jerrekt/Bricked-Sorting/cad/README.md

# CAD

- `v14/INTERFACE.md` and `v14/interface.json`: the shared spec for the V14 parallel CAD chats (frame, drawer, scoop, deck).
- `reference_v13/`: V13 parts and scripts to reuse or copy from (STEP, CadQuery 2.8 scripts, the V13 assembly placements in `assembly.json`). Reference only; V14 parts go in `v14/<module>/`.
