jerrekt/Bricked-Sorting/cad/v14/frame/cut_list.md

# V14 frame: wood cut list (interface 5)

All straight crosscuts. Nominal 2x2 = 38 x 38 actual, 1x2 = 19 x 38 actual (check the actual lumber; the skin clips assume 6 mm from wood face to skin). The store cuts the plywood.

| # | Piece | Stock | Cut (mm) | Cut (in) | Qty | Position |
|---|---|---|---|---|---|---|
| 100 | corner post | 2x2 | 600 | 23.62 | 4 | |x| 316..354, |y| 136..174, z 12..612 |
| 101 | top rail, long | 1x2 (38 tall) | 632 | 24.88 | 2 | y +-155..174, z 574..612, between the posts |
| 102 | top rail, short | 1x2 (38 tall) | 272 | 10.71 | 2 | x +-335..354, z 574..612, between the posts |
| 103 | deck cleat, long | 1x2 (38 tall) | 632 | 24.88 | 2 | y +-155..174, z 262..300 |
| 104 | deck cleat, short | 1x2 (38 tall) | 272 | 10.71 | 2 | x +-335..354, z 262..300 |
| 105 | bottom rail, short walls | 1x2 (38 tall) | 272 | 10.71 | 2 | x +-335..354, z 12..50 |
| 106 | beam post | 1x2 | 212 | 8.35 | 2 | x +-335..354, y -19..19, z 50..262 (vertical, 19 face toward the wall) |
| 109 | roof cross rail (under the hopper stud) | 1x2 laid FLAT | 310 | 12.20 | 2 | x -292 and -68 (centres), y -155..155 between the long top rails, z 593..612; 38 face up |
| 107 | floor plywood | 1/2 in ply | 720 x 360 | 28.35 x 14.17 | 1 | z 0..12 |
| 108 | deck plywood | 1/2 in ply | 708 x 348 | 27.87 x 13.70 | 1 | z 300..312; 38 x 38 notch at each corner; 56 mm (2 3/16 in) hole at (240, 0) for the drop funnel |

Stock: 2x2 x 8 ft x 1 (4 x 600 = 2400 of 2438, cut carefully), 1x2 x 8 ft x 3 (632 + 632 + 272 + 272 + 272 = 2080; 632 + 632 + 272 + 272 + 212 + 212 = 2232; 310 + 310 = 620), 1/2 in plywood 2 x 4 ft handy panel x 1.

## Wood-to-wood screws (pilot 2.5 mm for #6, 3 mm for #8)

| Joint | Screw | Qty | Where |
|---|---|---|---|
| posts to floor ply | #6 x 1-1/4 in, up from below the ply (12 ply + 20 into the post) | 16 | 4 per post, at the post centre (x +-335, y +-155) +-10 in x and y |
| long rails 101 / cleats 103 to posts | #8 x 2.5 in, through the post outer x face (+-354) into the rail end grain | 8 | 2 per rail end: y +-164.5, z 584 and 602 (rail) / 272 and 290 (cleat) |
| short rails 102 / cleats 104 / bottom rails 105 to posts | #8 x 2.5 in, through the post outer y face (+-174) into the end grain | 24 | 2 per end: x +-344.5, z 584/602, 272/290, 22/40 |
| beam post 106 to bottom rail 105 | #8 x 2.5 in, up from below the floor ply through rail 105 | 2 | at (+-344.5, 0) |
| beam post 106 to deck cleat 104 | #8 x 2.5 in, down through the cleat top | 2 | at (+-344.5, 0), before the deck ply goes on |
| deck ply 108 to cleats | #6 x 1.25 in, from above | 12 | 3 per cleat, on the cleat centreline (y +-164.5 / x +-344.5) |
| cross rails 109 to long top rails | #8 x 2.5 in toe-screwed (pocket style) down from the cross rail top face into the long rail, 2 per end, before the roof goes on | 8 | at x -292 / -68, y +-140, ~15 deg off vertical toward the long rail |

Order: posts onto the floor ply; bottom rails 105; beam posts 106; cleats 103/104; top rails 101/102; drill the clip pilots (drilling_map.md); clips; deck ply last (after the drawer rails, which screw into the floor).
