jerrekt/Bricked-Sorting/cad/v14/frame/drilling_map.md

# V14 frame: drilling map for the printed clips and keeper bars (interface 5)

Every hole: 2.5 mm pilot for a #6 x 3/4 in wood screw, drilled perpendicular to the face named, at the machine coordinates given (mm; origin floor centre, +Y front, +X the front viewer's left). Post outer faces are at y = +-174 (front/back) and x = +-354 (sides); the rail and cleat outer faces share those planes. The C3 roof clips go on the INNER faces of the top rails (y = +-155, x = +-335) at z 586: drill and fit them before the roof goes on.

| # | Part | Face | x | y | z | Holds |
|---|---|---|---|---|---|---|
| 1 | clip C1 | y +174 (post / cleat / rail outer face) | -328.7 | 174.0 | 62.0 | post, tile edge rib |
| 2 | clip C1 | y +174 (post / cleat / rail outer face) | -328.7 | 174.0 | 162.0 | post, tile edge rib |
| 3 | clip C1 | y +174 (post / cleat / rail outer face) | -301.0 | 174.0 | 274.5 | cleat, tile rib |
| 4 | clip C1 | y +174 (post / cleat / rail outer face) | -215.0 | 174.0 | 274.5 | cleat, tile rib |
| 5 | clip C1 | y +174 (post / cleat / rail outer face) | -328.7 | 174.0 | 262.0 | post, tile edge rib |
| 6 | clip C1 | y +174 (post / cleat / rail outer face) | -328.7 | 174.0 | 362.0 | post, tile edge rib |
| 7 | clip C1 | y +174 (post / cleat / rail outer face) | -301.0 | 174.0 | 586.5 | top rail, tile rib |
| 8 | clip C1 | y +174 (post / cleat / rail outer face) | -215.0 | 174.0 | 586.5 | top rail, tile rib |
| 9 | clip C1 | y +174 (post / cleat / rail outer face) | -328.7 | 174.0 | 462.0 | post, tile edge rib |
| 10 | clip C1 | y +174 (post / cleat / rail outer face) | -328.7 | 174.0 | 562.0 | post, tile edge rib |
| 11 | clip C1 | y +174 (post / cleat / rail outer face) | -145.0 | 174.0 | 274.5 | cleat, tile rib |
| 12 | clip C1 | y +174 (post / cleat / rail outer face) | -35.0 | 174.0 | 274.5 | cleat, tile rib |
| 13 | clip C1 | y +174 (post / cleat / rail outer face) | -145.0 | 174.0 | 586.5 | top rail, tile rib |
| 14 | clip C1 | y +174 (post / cleat / rail outer face) | -35.0 | 174.0 | 586.5 | top rail, tile rib |
| 15 | clip C1 | y +174 (post / cleat / rail outer face) | 35.0 | 174.0 | 274.5 | cleat, tile rib |
| 16 | clip C1 | y +174 (post / cleat / rail outer face) | 145.0 | 174.0 | 274.5 | cleat, tile rib |
| 17 | clip C1 | y +174 (post / cleat / rail outer face) | 35.0 | 174.0 | 586.5 | top rail, tile rib |
| 18 | clip C1 | y +174 (post / cleat / rail outer face) | 145.0 | 174.0 | 586.5 | top rail, tile rib |
| 19 | clip C1 | y +174 (post / cleat / rail outer face) | 328.7 | 174.0 | 62.0 | post, tile edge rib |
| 20 | clip C1 | y +174 (post / cleat / rail outer face) | 328.7 | 174.0 | 162.0 | post, tile edge rib |
| 21 | clip C1 | y +174 (post / cleat / rail outer face) | 215.0 | 174.0 | 274.5 | cleat, tile rib |
| 22 | clip C1 | y +174 (post / cleat / rail outer face) | 301.0 | 174.0 | 274.5 | cleat, tile rib |
| 23 | clip C1 | y +174 (post / cleat / rail outer face) | 328.7 | 174.0 | 262.0 | post, tile edge rib |
| 24 | clip C1 | y +174 (post / cleat / rail outer face) | 328.7 | 174.0 | 362.0 | post, tile edge rib |
| 25 | clip C1 | y +174 (post / cleat / rail outer face) | 215.0 | 174.0 | 586.5 | top rail, tile rib |
| 26 | clip C1 | y +174 (post / cleat / rail outer face) | 301.0 | 174.0 | 586.5 | top rail, tile rib |
| 27 | clip C1 | y +174 (post / cleat / rail outer face) | 328.7 | 174.0 | 462.0 | post, tile edge rib |
| 28 | clip C1 | y +174 (post / cleat / rail outer face) | 328.7 | 174.0 | 562.0 | post, tile edge rib |
| 29 | clip C1 | y -174 (post / cleat / rail outer face) | -328.7 | -174.0 | 62.0 | post, tile edge rib |
| 30 | clip C1 | y -174 (post / cleat / rail outer face) | -328.7 | -174.0 | 162.0 | post, tile edge rib |
| 31 | clip C1 | y -174 (post / cleat / rail outer face) | -301.0 | -174.0 | 274.5 | cleat, tile rib |
| 32 | clip C1 | y -174 (post / cleat / rail outer face) | -235.0 | -174.0 | 274.5 | cleat, tile rib |
| 33 | clip C1 | y -174 (post / cleat / rail outer face) | -328.7 | -174.0 | 262.0 | post, tile edge rib |
| 34 | clip C1 | y -174 (post / cleat / rail outer face) | -328.7 | -174.0 | 362.0 | post, tile edge rib |
| 35 | clip C1 | y -174 (post / cleat / rail outer face) | -301.0 | -174.0 | 586.5 | top rail, tile rib |
| 36 | clip C1 | y -174 (post / cleat / rail outer face) | -235.0 | -174.0 | 586.5 | top rail, tile rib |
| 37 | clip C1 | y -174 (post / cleat / rail outer face) | -328.7 | -174.0 | 462.0 | post, tile edge rib |
| 38 | clip C1 | y -174 (post / cleat / rail outer face) | -328.7 | -174.0 | 562.0 | post, tile edge rib |
| 39 | clip C1 | y -174 (post / cleat / rail outer face) | -130.0 | -174.0 | 274.5 | cleat, tile rib |
| 40 | clip C1 | y -174 (post / cleat / rail outer face) | -70.0 | -174.0 | 274.5 | cleat, tile rib |
| 41 | clip C1 | y -174 (post / cleat / rail outer face) | -130.0 | -174.0 | 586.5 | top rail, tile rib |
| 42 | clip C1 | y -174 (post / cleat / rail outer face) | -70.0 | -174.0 | 586.5 | top rail, tile rib |
| 43 | clip C1 | y -174 (post / cleat / rail outer face) | 70.0 | -174.0 | 274.5 | cleat, tile rib |
| 44 | clip C1 | y -174 (post / cleat / rail outer face) | 130.0 | -174.0 | 274.5 | cleat, tile rib |
| 45 | clip C1 | y -174 (post / cleat / rail outer face) | 70.0 | -174.0 | 586.5 | top rail, tile rib |
| 46 | clip C1 | y -174 (post / cleat / rail outer face) | 130.0 | -174.0 | 586.5 | top rail, tile rib |
| 47 | clip C1 | y -174 (post / cleat / rail outer face) | 328.7 | -174.0 | 62.0 | post, tile edge rib |
| 48 | clip C1 | y -174 (post / cleat / rail outer face) | 328.7 | -174.0 | 162.0 | post, tile edge rib |
| 49 | clip C1 | y -174 (post / cleat / rail outer face) | 235.0 | -174.0 | 274.5 | cleat, tile rib |
| 50 | clip C1 | y -174 (post / cleat / rail outer face) | 301.0 | -174.0 | 274.5 | cleat, tile rib |
| 51 | clip C1 | y -174 (post / cleat / rail outer face) | 328.7 | -174.0 | 262.0 | post, tile edge rib |
| 52 | clip C1 | y -174 (post / cleat / rail outer face) | 328.7 | -174.0 | 362.0 | post, tile edge rib |
| 53 | clip C1 | y -174 (post / cleat / rail outer face) | 235.0 | -174.0 | 586.5 | top rail, tile rib |
| 54 | clip C1 | y -174 (post / cleat / rail outer face) | 301.0 | -174.0 | 586.5 | top rail, tile rib |
| 55 | clip C1 | y -174 (post / cleat / rail outer face) | 328.7 | -174.0 | 462.0 | post, tile edge rib |
| 56 | clip C1 | y -174 (post / cleat / rail outer face) | 328.7 | -174.0 | 562.0 | post, tile edge rib |
| 57 | clip C1 | x +354 (post / rail outer face) | 354.0 | -121.0 | 24.5 | bottom rail, tile rib |
| 58 | clip C1 | x +354 (post / rail outer face) | 354.0 | -35.0 | 24.5 | bottom rail, tile rib |
| 59 | clip C1 | x +354 (post / rail outer face) | 354.0 | -148.7 | 62.0 | post, tile edge rib |
| 60 | clip C1 | x +354 (post / rail outer face) | 354.0 | -148.7 | 162.0 | post, tile edge rib |
| 61 | clip C2 | x +354 (post / rail outer face) | 354.0 | 7.3 | 110.0 | beam post, seam ribs |
| 62 | clip C2 | x +354 (post / rail outer face) | 354.0 | 7.3 | 185.0 | beam post, seam ribs |
| 63 | clip C1 | x +354 (post / rail outer face) | 354.0 | -121.0 | 274.5 | cleat, tile rib |
| 64 | clip C1 | x +354 (post / rail outer face) | 354.0 | -35.0 | 274.5 | cleat, tile rib |
| 65 | clip C1 | x +354 (post / rail outer face) | 354.0 | -148.7 | 262.0 | post, tile edge rib |
| 66 | clip C1 | x +354 (post / rail outer face) | 354.0 | -148.7 | 362.0 | post, tile edge rib |
| 67 | clip C2 | x +354 (post / rail outer face) | 354.0 | 7.3 | 240.0 | beam post, seam ribs |
| 68 | clip C1 | x +354 (post / rail outer face) | 354.0 | -121.0 | 586.5 | top rail, tile rib |
| 69 | clip C1 | x +354 (post / rail outer face) | 354.0 | -35.0 | 586.5 | top rail, tile rib |
| 70 | clip C1 | x +354 (post / rail outer face) | 354.0 | -148.7 | 462.0 | post, tile edge rib |
| 71 | clip C1 | x +354 (post / rail outer face) | 354.0 | -148.7 | 562.0 | post, tile edge rib |
| 72 | clip C1 | x +354 (post / rail outer face) | 354.0 | 35.0 | 24.5 | bottom rail, tile rib |
| 73 | clip C1 | x +354 (post / rail outer face) | 354.0 | 121.0 | 24.5 | bottom rail, tile rib |
| 74 | clip C1 | x +354 (post / rail outer face) | 354.0 | 148.7 | 62.0 | post, tile edge rib |
| 75 | clip C1 | x +354 (post / rail outer face) | 354.0 | 148.7 | 162.0 | post, tile edge rib |
| 76 | clip C1 | x +354 (post / rail outer face) | 354.0 | 35.0 | 274.5 | cleat, tile rib |
| 77 | clip C1 | x +354 (post / rail outer face) | 354.0 | 121.0 | 274.5 | cleat, tile rib |
| 78 | clip C1 | x +354 (post / rail outer face) | 354.0 | 148.7 | 262.0 | post, tile edge rib |
| 79 | clip C1 | x +354 (post / rail outer face) | 354.0 | 148.7 | 362.0 | post, tile edge rib |
| 80 | clip C1 | x +354 (post / rail outer face) | 354.0 | 35.0 | 586.5 | top rail, tile rib |
| 81 | clip C1 | x +354 (post / rail outer face) | 354.0 | 121.0 | 586.5 | top rail, tile rib |
| 82 | clip C1 | x +354 (post / rail outer face) | 354.0 | 148.7 | 462.0 | post, tile edge rib |
| 83 | clip C1 | x +354 (post / rail outer face) | 354.0 | 148.7 | 562.0 | post, tile edge rib |
| 84 | clip C1 | x -354 (post / rail outer face) | -354.0 | -121.0 | 24.5 | bottom rail, tile rib |
| 85 | clip C1 | x -354 (post / rail outer face) | -354.0 | -35.0 | 24.5 | bottom rail, tile rib |
| 86 | clip C1 | x -354 (post / rail outer face) | -354.0 | -148.7 | 62.0 | post, tile edge rib |
| 87 | clip C1 | x -354 (post / rail outer face) | -354.0 | -148.7 | 162.0 | post, tile edge rib |
| 88 | clip C2 | x -354 (post / rail outer face) | -354.0 | -7.3 | 110.0 | beam post, seam ribs |
| 89 | clip C2 | x -354 (post / rail outer face) | -354.0 | -7.3 | 185.0 | beam post, seam ribs |
| 90 | clip C1 | x -354 (post / rail outer face) | -354.0 | -121.0 | 274.5 | cleat, tile rib |
| 91 | clip C1 | x -354 (post / rail outer face) | -354.0 | -35.0 | 274.5 | cleat, tile rib |
| 92 | clip C1 | x -354 (post / rail outer face) | -354.0 | -148.7 | 262.0 | post, tile edge rib |
| 93 | clip C1 | x -354 (post / rail outer face) | -354.0 | -148.7 | 362.0 | post, tile edge rib |
| 94 | clip C2 | x -354 (post / rail outer face) | -354.0 | -7.3 | 240.0 | beam post, seam ribs |
| 95 | clip C1 | x -354 (post / rail outer face) | -354.0 | -121.0 | 586.5 | top rail, tile rib |
| 96 | clip C1 | x -354 (post / rail outer face) | -354.0 | -35.0 | 586.5 | top rail, tile rib |
| 97 | clip C1 | x -354 (post / rail outer face) | -354.0 | -148.7 | 462.0 | post, tile edge rib |
| 98 | clip C1 | x -354 (post / rail outer face) | -354.0 | -148.7 | 562.0 | post, tile edge rib |
| 99 | clip C1 | x -354 (post / rail outer face) | -354.0 | 35.0 | 24.5 | bottom rail, tile rib |
| 100 | clip C1 | x -354 (post / rail outer face) | -354.0 | 121.0 | 24.5 | bottom rail, tile rib |
| 101 | clip C1 | x -354 (post / rail outer face) | -354.0 | 148.7 | 62.0 | post, tile edge rib |
| 102 | clip C1 | x -354 (post / rail outer face) | -354.0 | 148.7 | 162.0 | post, tile edge rib |
| 103 | clip C1 | x -354 (post / rail outer face) | -354.0 | 35.0 | 274.5 | cleat, tile rib |
| 104 | clip C1 | x -354 (post / rail outer face) | -354.0 | 121.0 | 274.5 | cleat, tile rib |
| 105 | clip C1 | x -354 (post / rail outer face) | -354.0 | 148.7 | 262.0 | post, tile edge rib |
| 106 | clip C1 | x -354 (post / rail outer face) | -354.0 | 148.7 | 362.0 | post, tile edge rib |
| 107 | clip C1 | x -354 (post / rail outer face) | -354.0 | 35.0 | 586.5 | top rail, tile rib |
| 108 | clip C1 | x -354 (post / rail outer face) | -354.0 | 121.0 | 586.5 | top rail, tile rib |
| 109 | clip C1 | x -354 (post / rail outer face) | -354.0 | 148.7 | 462.0 | post, tile edge rib |
| 110 | clip C1 | x -354 (post / rail outer face) | -354.0 | 148.7 | 562.0 | post, tile edge rib |
| 111 | clip C1 | y -174 (post / cleat / rail outer face) | -339.5 | -174.0 | 112.0 | post, corner cap rib |
| 112 | clip C1 | x -354 (post / rail outer face) | -354.0 | -160.5 | 112.0 | post, corner cap rib |
| 113 | clip C1 | y -174 (post / cleat / rail outer face) | -339.5 | -174.0 | 312.0 | post, corner cap rib |
| 114 | clip C1 | x -354 (post / rail outer face) | -354.0 | -160.5 | 312.0 | post, corner cap rib |
| 115 | clip C1 | y -174 (post / cleat / rail outer face) | -339.5 | -174.0 | 512.0 | post, corner cap rib |
| 116 | clip C1 | x -354 (post / rail outer face) | -354.0 | -160.5 | 512.0 | post, corner cap rib |
| 117 | clip C1 | y +174 (post / cleat / rail outer face) | -339.5 | 174.0 | 112.0 | post, corner cap rib |
| 118 | clip C1 | x -354 (post / rail outer face) | -354.0 | 160.5 | 112.0 | post, corner cap rib |
| 119 | clip C1 | y +174 (post / cleat / rail outer face) | -339.5 | 174.0 | 312.0 | post, corner cap rib |
| 120 | clip C1 | x -354 (post / rail outer face) | -354.0 | 160.5 | 312.0 | post, corner cap rib |
| 121 | clip C1 | y +174 (post / cleat / rail outer face) | -339.5 | 174.0 | 512.0 | post, corner cap rib |
| 122 | clip C1 | x -354 (post / rail outer face) | -354.0 | 160.5 | 512.0 | post, corner cap rib |
| 123 | clip C1 | y -174 (post / cleat / rail outer face) | 339.5 | -174.0 | 112.0 | post, corner cap rib |
| 124 | clip C1 | x +354 (post / rail outer face) | 354.0 | -160.5 | 112.0 | post, corner cap rib |
| 125 | clip C1 | y -174 (post / cleat / rail outer face) | 339.5 | -174.0 | 312.0 | post, corner cap rib |
| 126 | clip C1 | x +354 (post / rail outer face) | 354.0 | -160.5 | 312.0 | post, corner cap rib |
| 127 | clip C1 | y -174 (post / cleat / rail outer face) | 339.5 | -174.0 | 512.0 | post, corner cap rib |
| 128 | clip C1 | x +354 (post / rail outer face) | 354.0 | -160.5 | 512.0 | post, corner cap rib |
| 129 | clip C1 | y +174 (post / cleat / rail outer face) | 339.5 | 174.0 | 112.0 | post, corner cap rib |
| 130 | clip C1 | x +354 (post / rail outer face) | 354.0 | 160.5 | 112.0 | post, corner cap rib |
| 131 | clip C1 | y +174 (post / cleat / rail outer face) | 339.5 | 174.0 | 312.0 | post, corner cap rib |
| 132 | clip C1 | x +354 (post / rail outer face) | 354.0 | 160.5 | 312.0 | post, corner cap rib |
| 133 | clip C1 | y +174 (post / cleat / rail outer face) | 339.5 | 174.0 | 512.0 | post, corner cap rib |
| 134 | clip C1 | x +354 (post / rail outer face) | 354.0 | 160.5 | 512.0 | post, corner cap rib |
| 135 | clip C3 | long top rail inner face y -155 | -244.0 | -155.0 | 586.2 | top rail inner face, roof rib |
| 136 | clip C3 | long top rail inner face y -155 | -210.0 | -155.0 | 586.2 | top rail inner face, roof rib |
| 137 | clip C3 | short top rail inner face x -335 | -335.0 | -120.0 | 586.2 | short top rail inner face, roof rib |
| 138 | clip C3 | short top rail inner face x -335 | -335.0 | -60.0 | 586.2 | short top rail inner face, roof rib |
| 139 | clip C3 | long top rail inner face y +155 | -244.0 | 155.0 | 586.2 | top rail inner face, roof rib |
| 140 | clip C3 | long top rail inner face y +155 | -210.0 | 155.0 | 586.2 | top rail inner face, roof rib |
| 141 | clip C3 | short top rail inner face x -335 | -335.0 | 60.0 | 586.2 | short top rail inner face, roof rib |
| 142 | clip C3 | short top rail inner face x -335 | -335.0 | 120.0 | 586.2 | short top rail inner face, roof rib |
| 143 | clip C3 | long top rail inner face y -155 | -150.0 | -155.0 | 586.2 | top rail inner face, roof rib |
| 144 | clip C3 | long top rail inner face y -155 | -30.0 | -155.0 | 586.2 | top rail inner face, roof rib |
| 145 | clip C3 | long top rail inner face y +155 | -150.0 | 155.0 | 586.2 | top rail inner face, roof rib |
| 146 | clip C3 | long top rail inner face y +155 | -30.0 | 155.0 | 586.2 | top rail inner face, roof rib |
| 147 | clip C3 | long top rail inner face y -155 | 30.0 | -155.0 | 586.2 | top rail inner face, roof rib |
| 148 | clip C3 | long top rail inner face y -155 | 150.0 | -155.0 | 586.2 | top rail inner face, roof rib |
| 149 | clip C3 | long top rail inner face y +155 | 30.0 | 155.0 | 586.2 | top rail inner face, roof rib |
| 150 | clip C3 | long top rail inner face y +155 | 150.0 | 155.0 | 586.2 | top rail inner face, roof rib |
| 151 | clip C3 | long top rail inner face y -155 | 210.0 | -155.0 | 586.2 | top rail inner face, roof rib |
| 152 | clip C3 | long top rail inner face y -155 | 280.0 | -155.0 | 586.2 | top rail inner face, roof rib |
| 153 | clip C3 | short top rail inner face x +335 | 335.0 | -120.0 | 586.2 | short top rail inner face, roof rib |
| 154 | clip C3 | short top rail inner face x +335 | 335.0 | -60.0 | 586.2 | short top rail inner face, roof rib |
| 155 | clip C3 | long top rail inner face y +155 | 210.0 | 155.0 | 586.2 | top rail inner face, roof rib |
| 156 | clip C3 | long top rail inner face y +155 | 280.0 | 155.0 | 586.2 | top rail inner face, roof rib |
| 157 | clip C3 | short top rail inner face x +335 | 335.0 | 60.0 | 586.2 | short top rail inner face, roof rib |
| 158 | clip C3 | short top rail inner face x +335 | 335.0 | 120.0 | 586.2 | short top rail inner face, roof rib |
| 159 | keeper bar 116 | y -174 (deck cleat outer face) | -150.0 | -174.0 | 281.0 | access panel keeper |
| 160 | keeper bar 117 | y -174 (top rail outer face) | -150.0 | -174.0 | 593.0 | access panel keeper |
| 161 | keeper bar 116 | y -174 (deck cleat outer face) | -50.0 | -174.0 | 281.0 | access panel keeper |
| 162 | keeper bar 117 | y -174 (top rail outer face) | -50.0 | -174.0 | 593.0 | access panel keeper |
| 163 | keeper bar 116 | y -174 (deck cleat outer face) | 50.0 | -174.0 | 281.0 | access panel keeper |
| 164 | keeper bar 117 | y -174 (top rail outer face) | 50.0 | -174.0 | 593.0 | access panel keeper |
| 165 | keeper bar 116 | y -174 (deck cleat outer face) | 150.0 | -174.0 | 281.0 | access panel keeper |
| 166 | keeper bar 117 | y -174 (top rail outer face) | 150.0 | -174.0 | 593.0 | access panel keeper |

Total: 166 #6 screws. Wood-to-wood screws are in cut_list.md; deck-module screws into the deck ply are in the deck README.
