jerrekt/Bricked-Sorting/cad/reference_v13/v13_closed.png

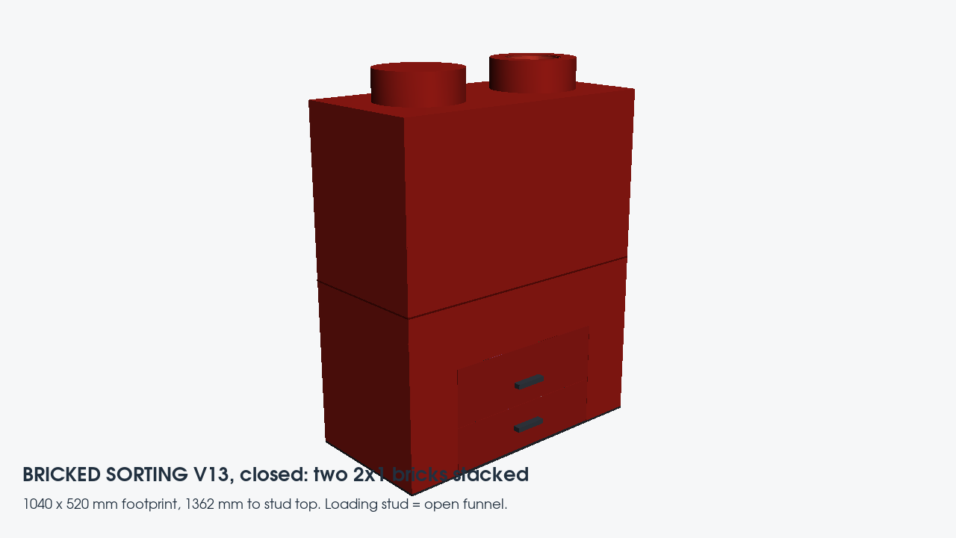
cad/reference_v13/v13_closed.png
