jerrekt/Bricked-Sorting/cad/reference_v13/v13_no_shell.png

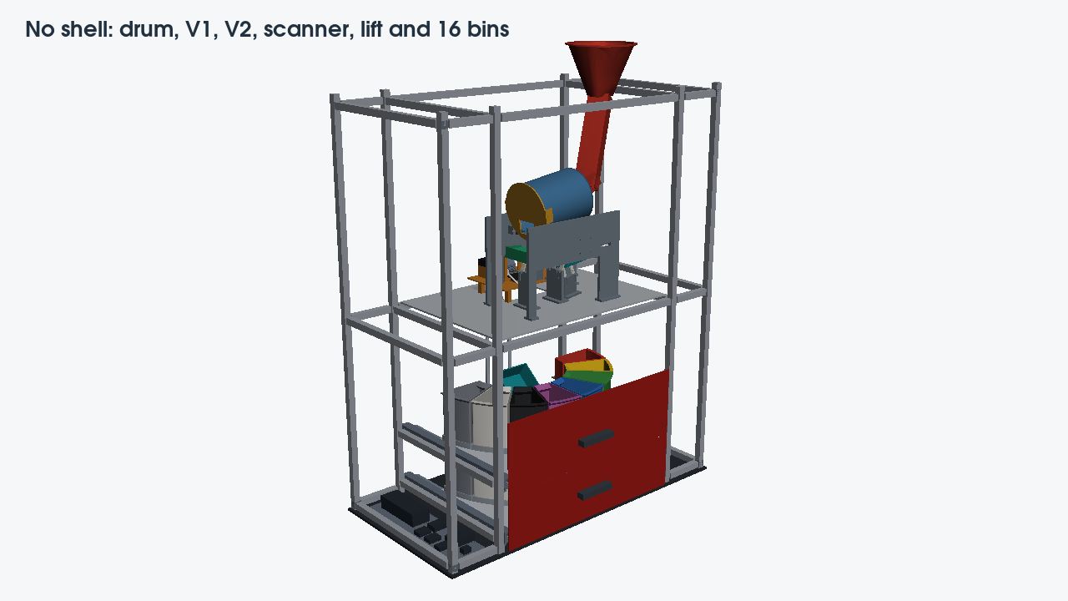
cad/reference_v13/v13_no_shell.png
