jerrekt/Bricked-Sorting/cad/reference_v13/v13_scanner.png

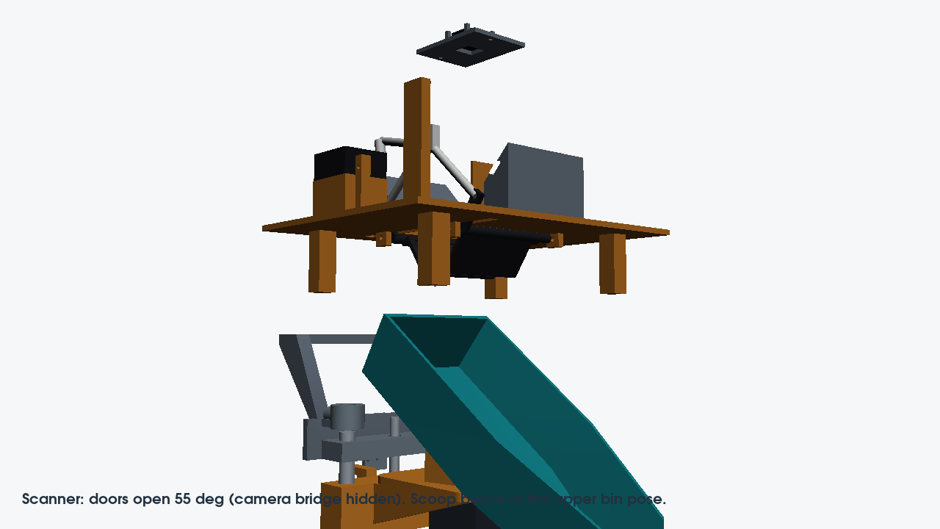
cad/reference_v13/v13_scanner.png
