jerrekt/Bricked-Sorting/cad/v14/frame/drilling_map.png

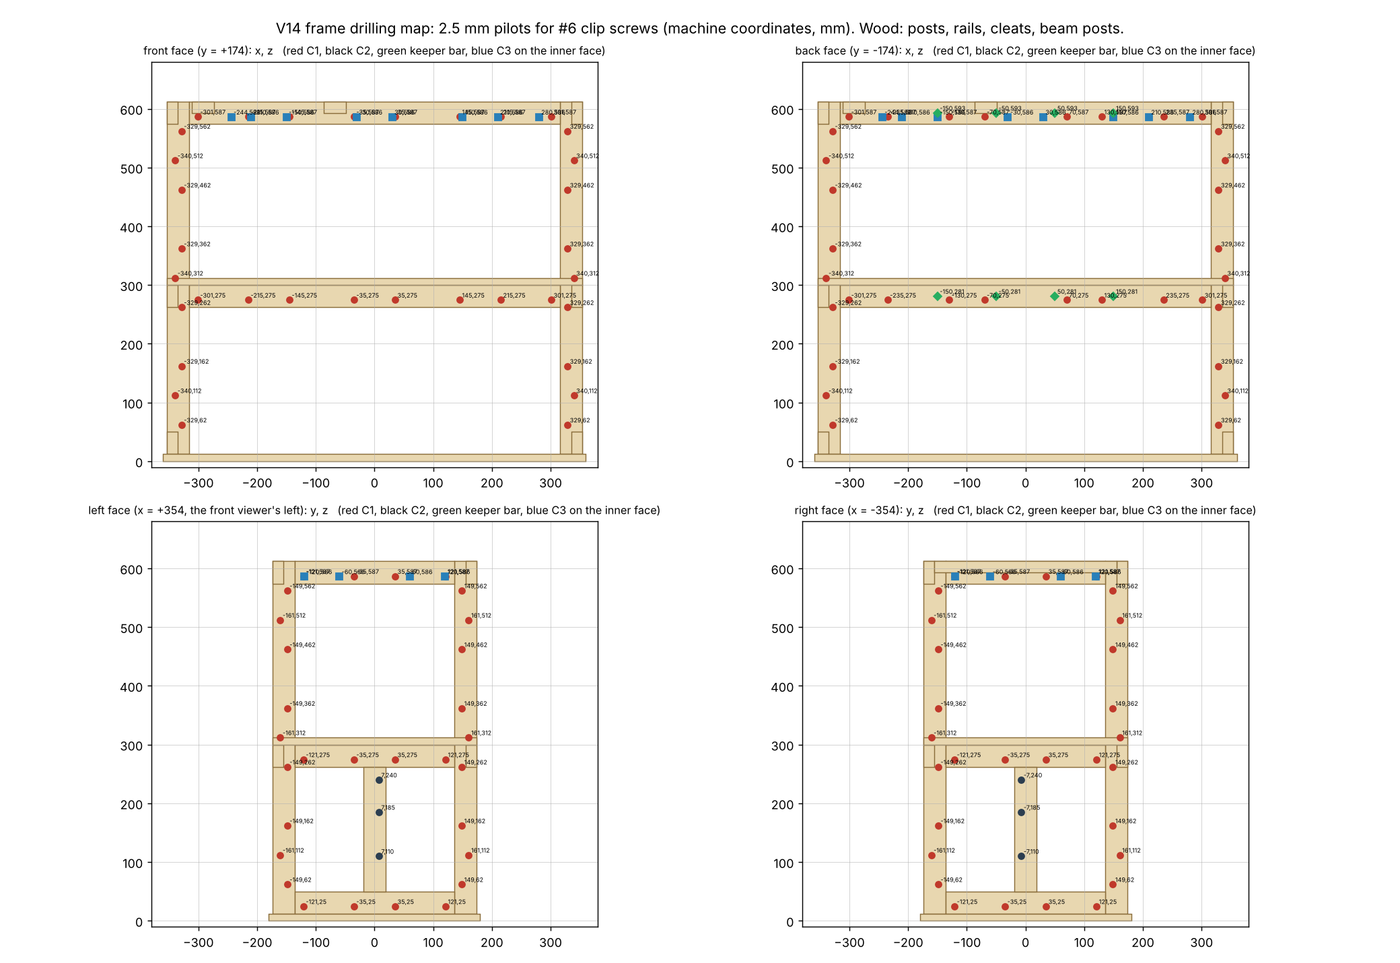
cad/v14/frame/drilling_map.png
