jerrekt/Bricked-Sorting/cad/v14/frame/still_1_front_left.png

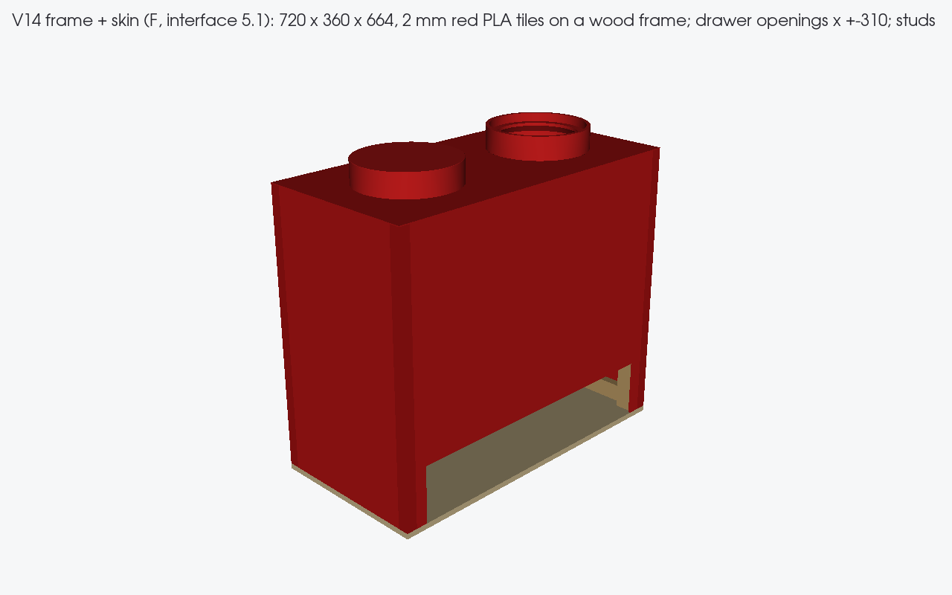
cad/v14/frame/still_1_front_left.png
