jerrekt/Bricked-Sorting/cad/v14/frame/still_2_back_right.png

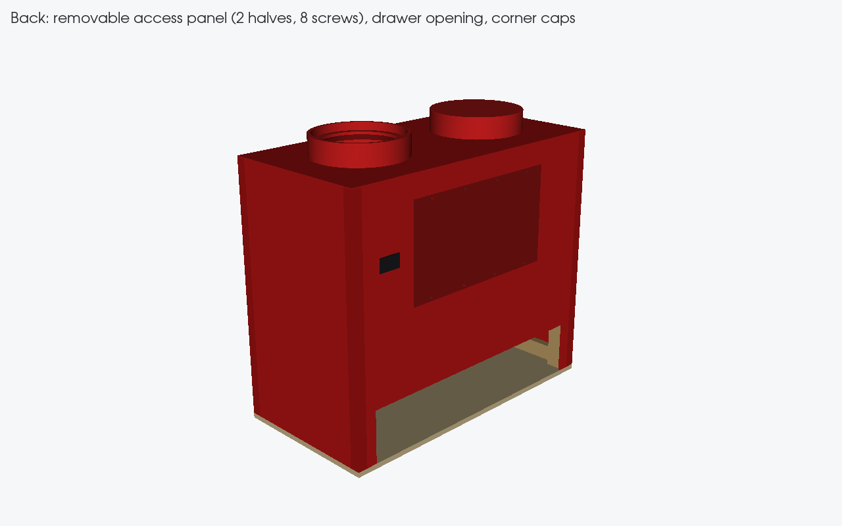
cad/v14/frame/still_2_back_right.png
