jerrekt/Bricked-Sorting/cad/v14/frame/still_3_wood_and_clips.png

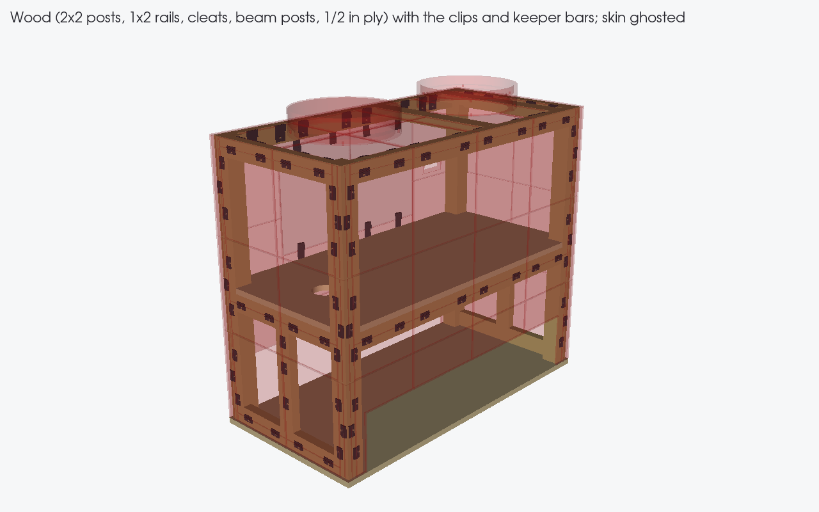
cad/v14/frame/still_3_wood_and_clips.png
