jerrekt/Bricked-Sorting/cad/v14/frame/still_4_clip_detail.png

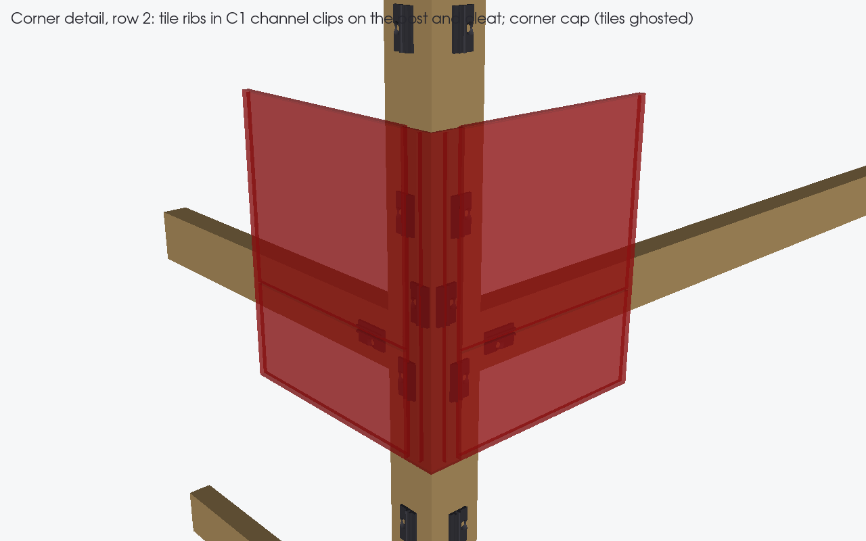
cad/v14/frame/still_4_clip_detail.png
