jerrekt/Bricked-Sorting/cad/v14_layout_sketch.png

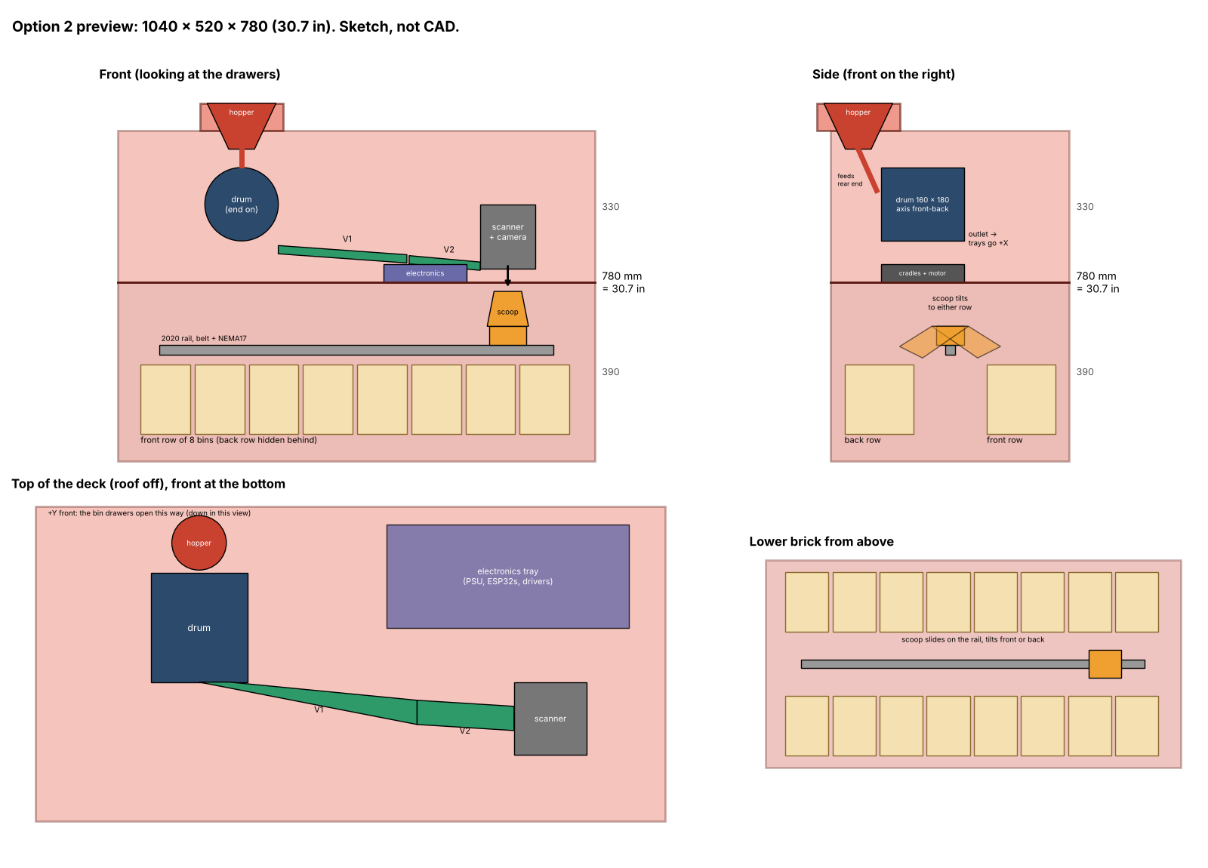
cad/v14_layout_sketch.png
