jerrekt/Bricked-Sorting/cad/v14/frame/world/frame_assembly.step

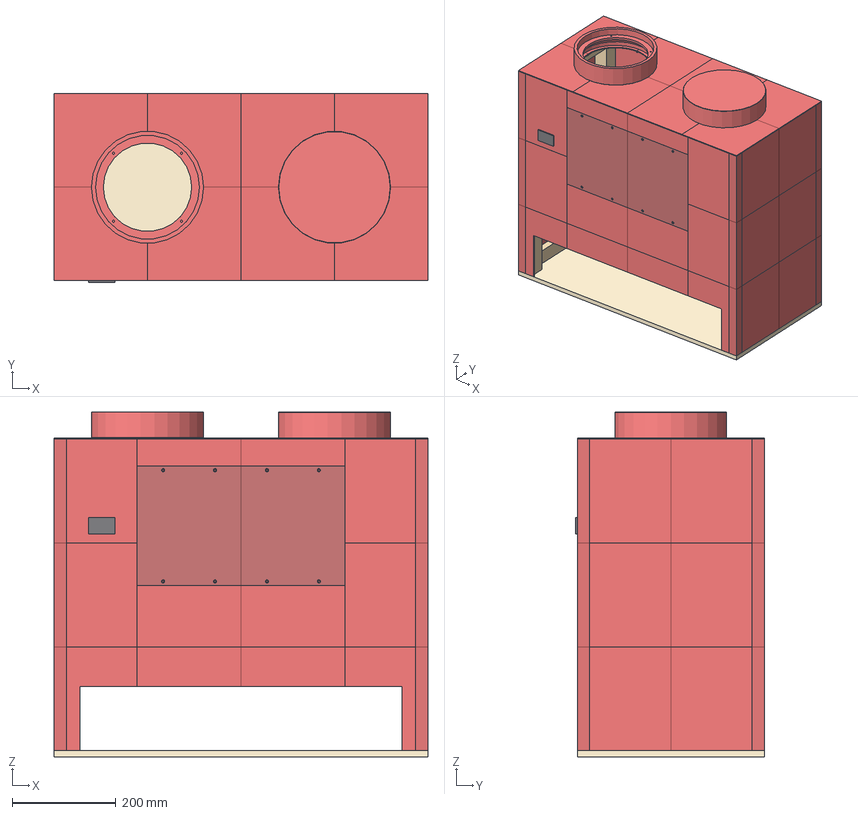
[picture p10: CAD file, 2026-11-10]
cad/v14/frame/world/frame_assembly.step
720.0 x 363.0 x 664.0 mm
100_post_2x2_RB
100_post_2x2_RF
100_post_2x2_LB
100_post_2x2_LF
101_top_rail_long_B
101_top_rail_long_F
102_top_rail_short_R
102_top_rail_short_L
103_deck_cleat_long_B
103_deck_cleat_long_F
104_deck_cleat_short_R
104_deck_cleat_short_L
105_bottom_rail_short_R
105_bottom_rail_short_L
106_beam_post_R
106_beam_post_L
109_roof_cross_rail_1
109_roof_cross_rail_2
107_floor_ply
108_deck_ply
110_tile_F_c1_r1
110_tile_F_c1_r2
110_tile_F_c1_r3
110_tile_F_c2_r1
110_tile_F_c2_r2
110_tile_F_c2_r3
110_tile_F_c3_r1
110_tile_F_c3_r2
110_tile_F_c3_r3
110_tile_F_c4_r1
110_tile_F_c4_r2
110_tile_F_c4_r3
111_tile_B_c1_r1
111_tile_B_c1_r2
111_tile_B_c1_r3
111_tile_B_c2_r1
111_tile_B_c2_r2
111_tile_B_c2_r3
115_access_panel_x_neg
111_tile_B_c3_r1
111_tile_B_c3_r2
111_tile_B_c3_r3
115_access_panel_x_pos
111_tile_B_c4_r1
111_tile_B_c4_r2
111_tile_B_c4_r3
112_tile_L_c1_r1
112_tile_L_c1_r2
112_tile_L_c1_r3
112_tile_L_c2_r1
112_tile_L_c2_r2
112_tile_L_c2_r3
113_tile_R_c1_r1
113_tile_R_c1_r2
113_tile_R_c1_r3
113_tile_R_c2_r1
113_tile_R_c2_r2
113_tile_R_c2_r3
116_panel_keeper_bottom_x-150
117_panel_keeper_top_x-150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
