jerrekt/Bricked-Sorting/cad/reference_v13/bins_v10/40_bin_lower_PRINT_8.step

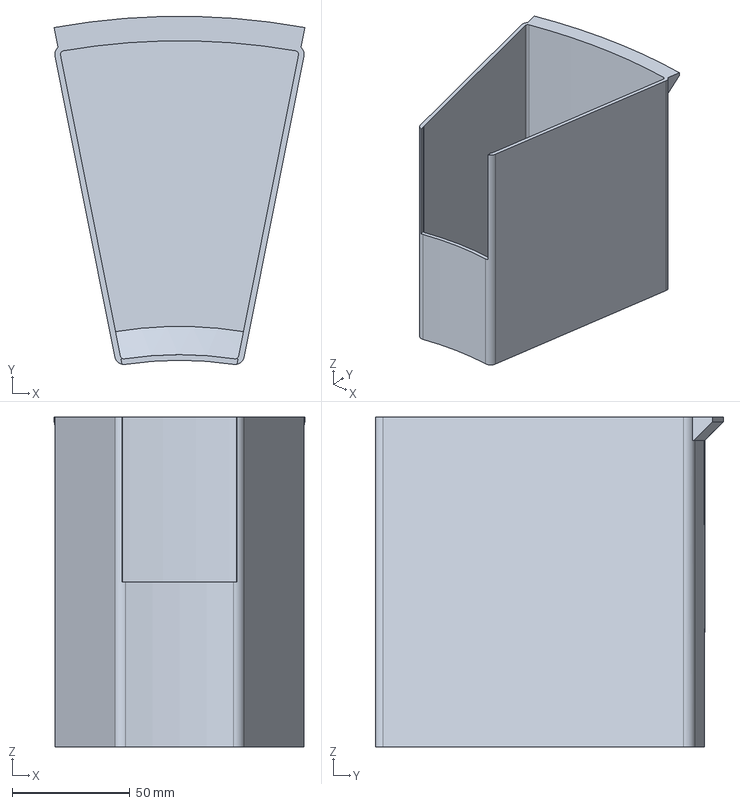
[picture p11: CAD file, 2026-11-06]
cad/reference_v13/bins_v10/40_bin_lower_PRINT_8.step
106.4 x 147.7 x 140.0 mm
