jerrekt/Bricked-Sorting/cad/reference_v13/carriage_v3/04_lower_switch_mount.step

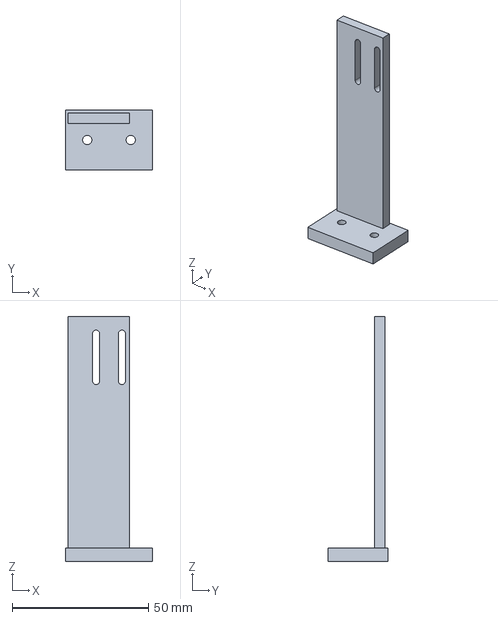
[picture p12: CAD file, 2026-11-06]
cad/reference_v13/carriage_v3/04_lower_switch_mount.step
32.0 x 22.0 x 90.0 mm
