jerrekt/Bricked-Sorting/cad/reference_v13/deck_v13/58_trapdoor_PRINT_2.step

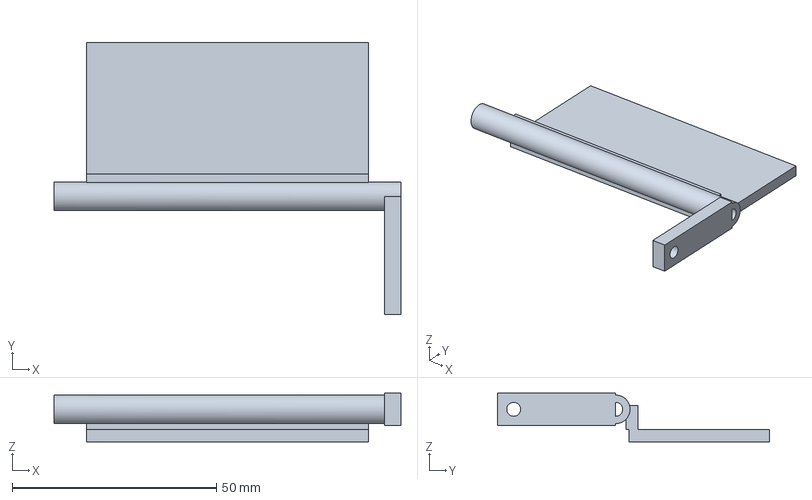
[picture p13: CAD file, 2026-11-06]
cad/reference_v13/deck_v13/58_trapdoor_PRINT_2.step
85.0 x 66.7 x 12.0 mm
