jerrekt/Bricked-Sorting/cad/reference_v13/drum_v13/47b_tumbler_barrel_helical_flight.step

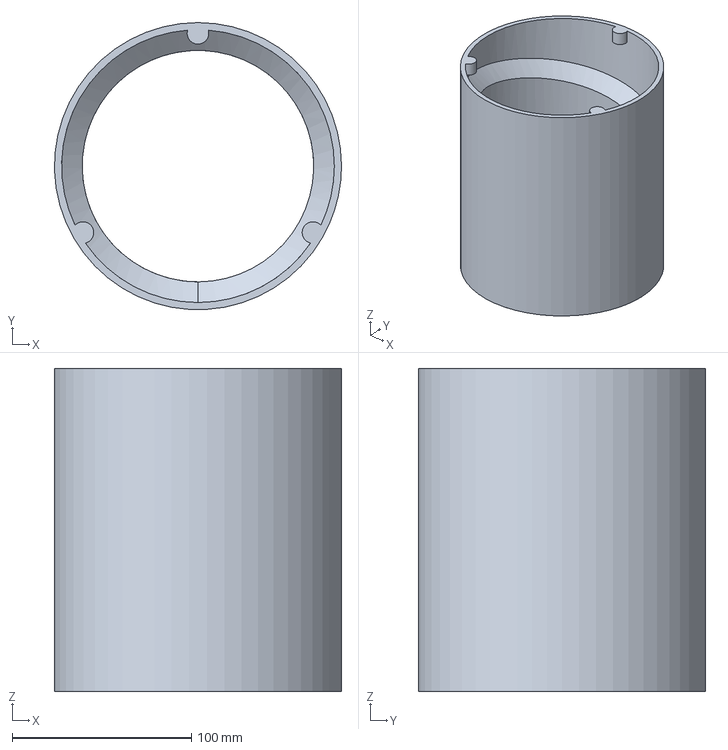
[picture p14: CAD file, 2026-11-06]
cad/reference_v13/drum_v13/47b_tumbler_barrel_helical_flight.step
160.0 x 159.8 x 180.0 mm
