jerrekt/Bricked-Sorting/cad/reference_v13/frame_v13/75b_latch_pivot_ear_PRINT_2.step

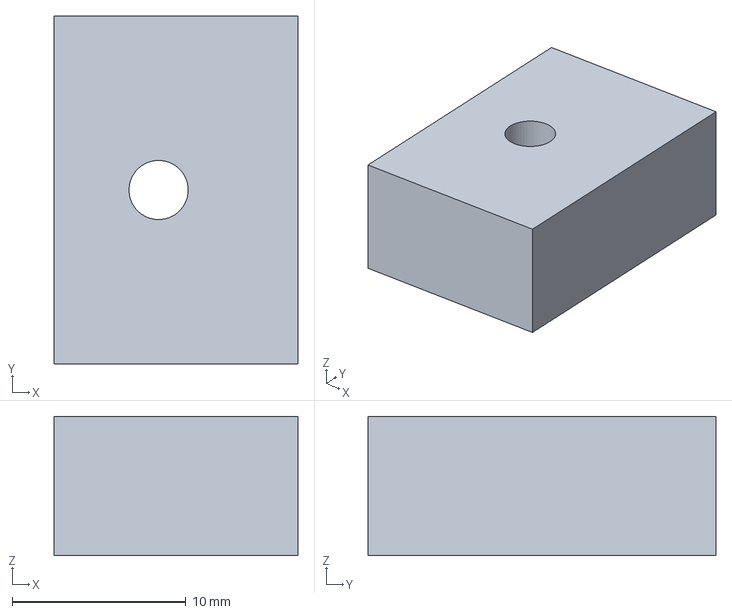
[picture p15: CAD file, 2026-11-06]
cad/reference_v13/frame_v13/75b_latch_pivot_ear_PRINT_2.step
14.0 x 20.0 x 8.00 mm
