jerrekt/Bricked-Sorting/cad/v14/frame/print/131_stud_cap_right_PRINT_1.stl

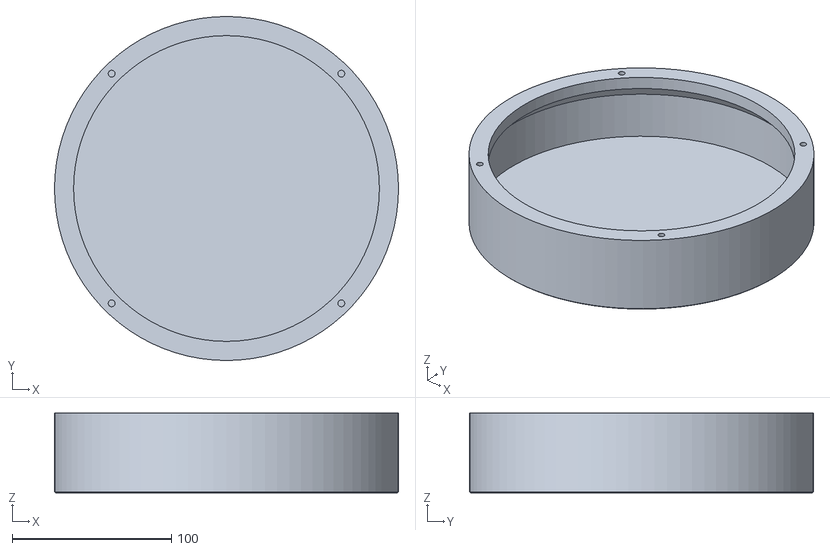
[picture p16: CAD file, 2026-11-10]
cad/v14/frame/print/131_stud_cap_right_PRINT_1.stl
216.0 x 216.0 x 50.0
