jerrekt/Bricked-Sorting/cad/v14/frame/world/135_corner_cap_RB_r2.step

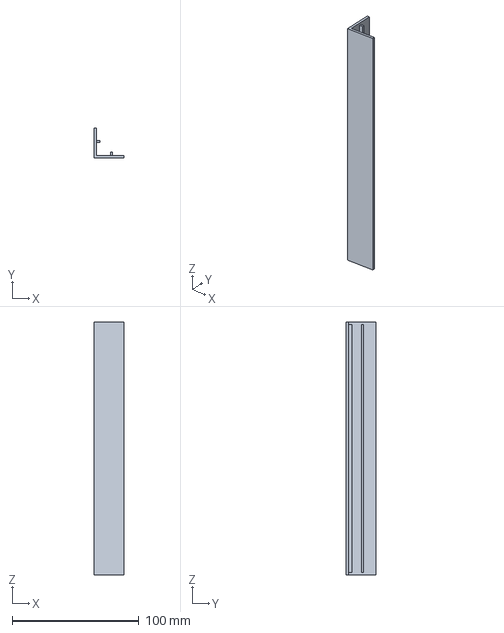
[picture p17: CAD file, 2026-11-10]
cad/v14/frame/world/135_corner_cap_RB_r2.step
24.0 x 24.0 x 200.0 mm
