jerrekt/Bricked-Sorting/cad/reference_v13/bins_v10/43_compact_scoop_PRINT_FLAT.step

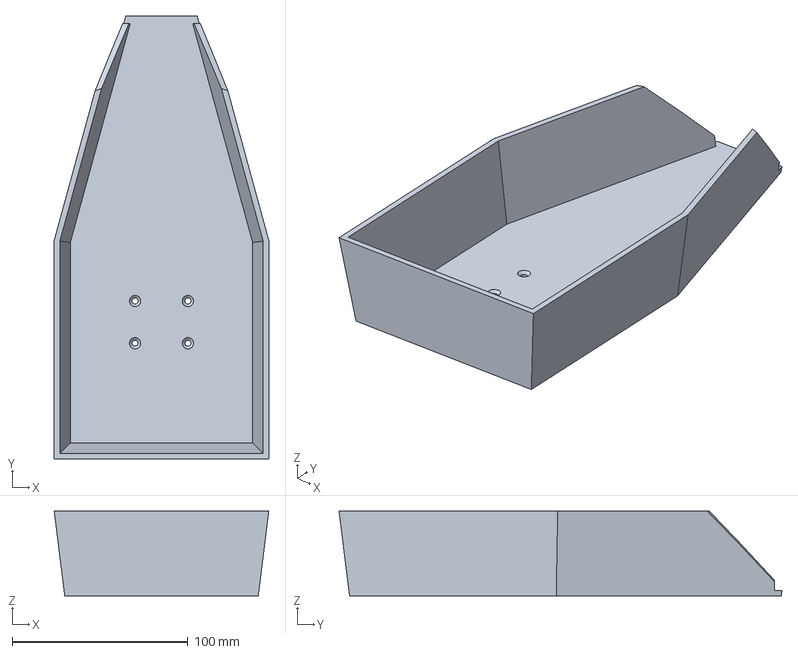
[picture p18: CAD file, 2026-11-06]
cad/reference_v13/bins_v10/43_compact_scoop_PRINT_FLAT.step
122.0 x 251.8 x 48.2 mm
