jerrekt/Bricked-Sorting/cad/reference_v13/carriage_v3/05_open_scoop_PRINT_FLAT.step

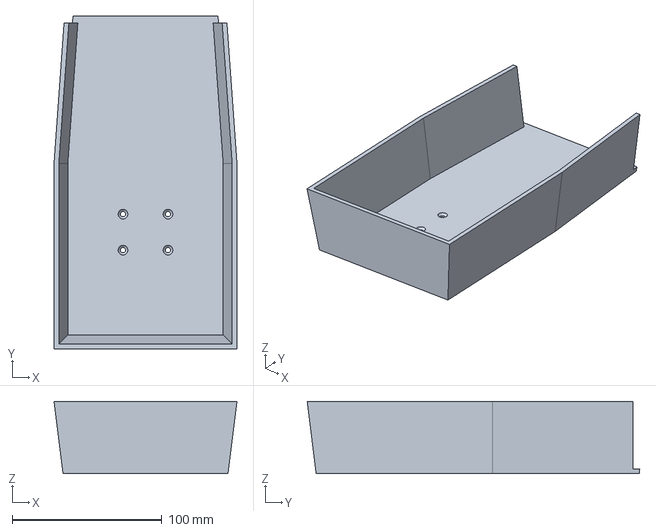
[picture p19: CAD file, 2026-11-06]
cad/reference_v13/carriage_v3/05_open_scoop_PRINT_FLAT.step
122.0 x 221.8 x 48.2 mm
