jerrekt/Bricked-Sorting/cad/reference_v13/deck_v13/57b_landing_ramp.step

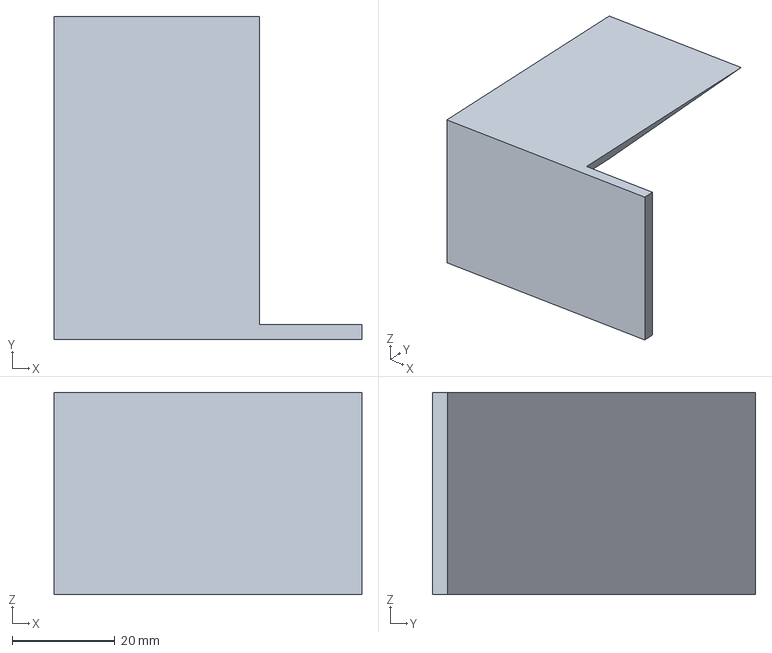
[picture p20: CAD file, 2026-11-06]
cad/reference_v13/deck_v13/57b_landing_ramp.step
60.0 x 63.0 x 39.4 mm
