jerrekt/Bricked-Sorting/cad/reference_v13/drum_v13/49b_drum_static_outlet_plate.step

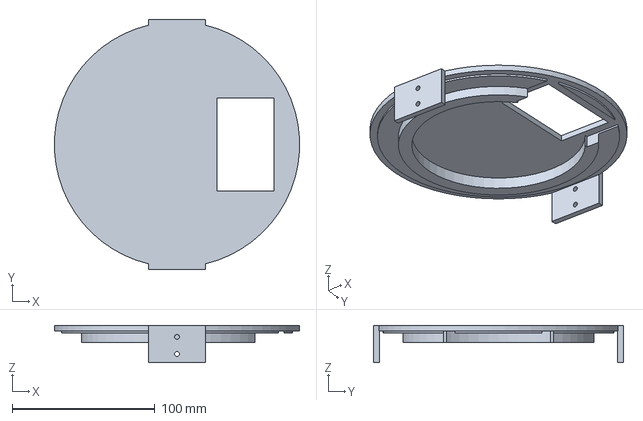
[picture p21: CAD file, 2026-11-06]
cad/reference_v13/drum_v13/49b_drum_static_outlet_plate.step
171.8 x 175.0 x 26.0 mm
