jerrekt/Bricked-Sorting/cad/v14/frame/print/130_stud_ring_left_hopper_PRINT_1.stl

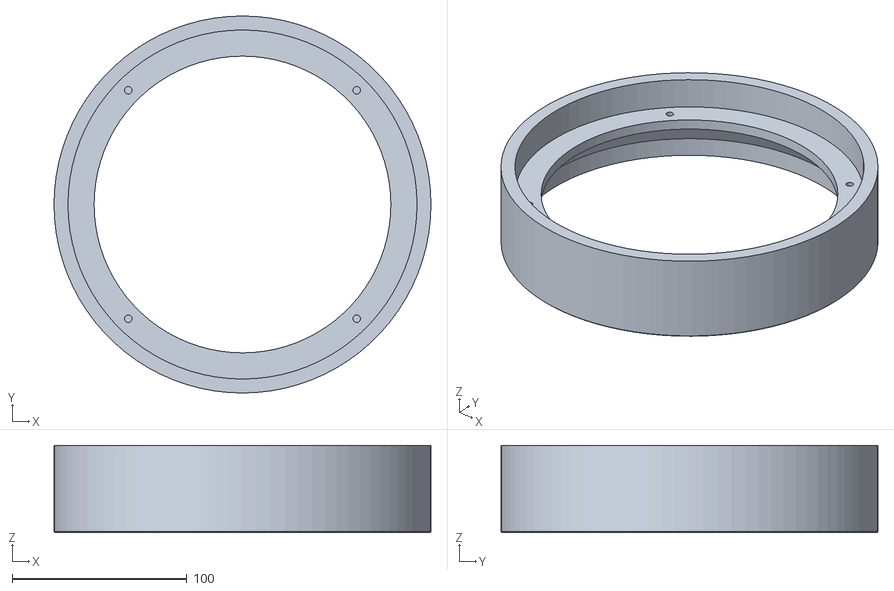
[picture p23: CAD file, 2026-11-09]
cad/v14/frame/print/130_stud_ring_left_hopper_PRINT_1.stl
216.0 x 216.0 x 50.0
