jerrekt/Bricked-Sorting/cad/v14/frame/world/112_tile_L_c2_r2.step

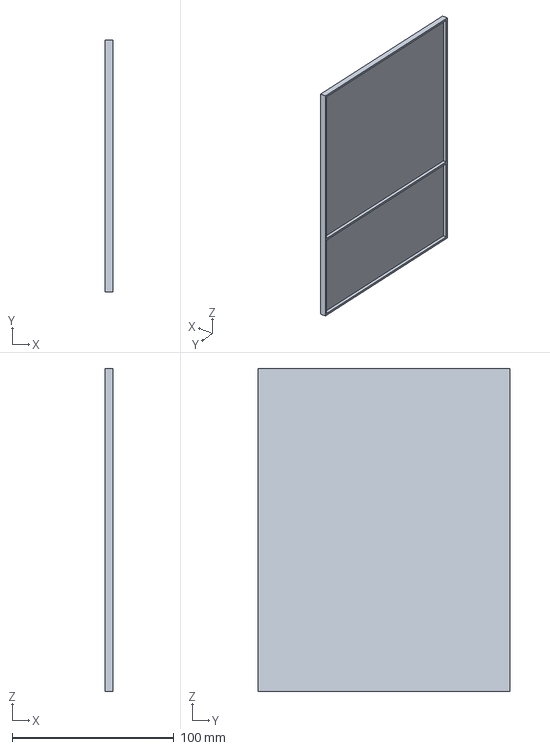
[picture p24: CAD file, 2026-11-10]
cad/v14/frame/world/112_tile_L_c2_r2.step
4.79 x 156.0 x 200.0 mm
