jerrekt/Bricked-Sorting/cad/reference_v13/bins_v10/42_bin_locator_PRINT_16.step

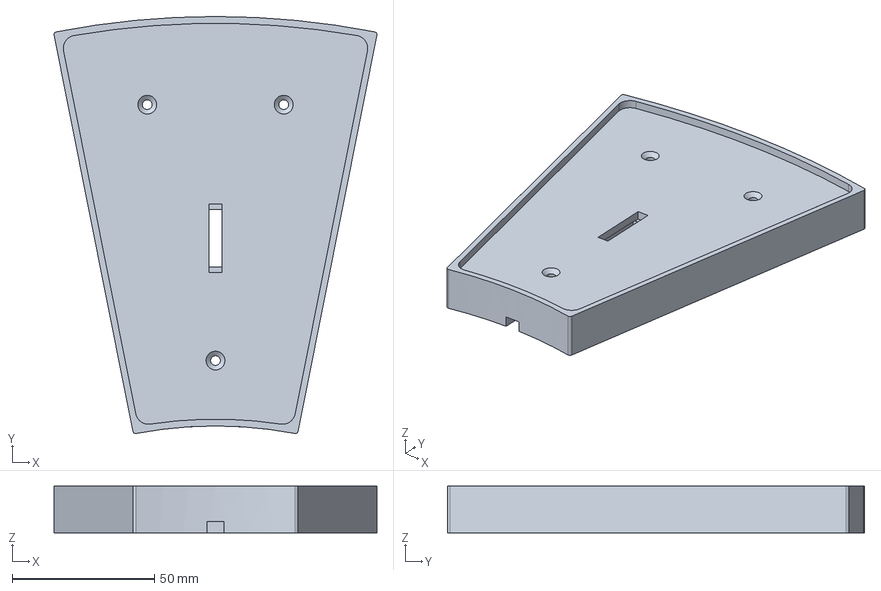
[picture p25: CAD file, 2026-11-06]
cad/reference_v13/bins_v10/42_bin_locator_PRINT_16.step
113.6 x 146.7 x 16.5 mm
