jerrekt/Bricked-Sorting/cad/reference_v13/carriage_v3/09_shaft_fit_test.step

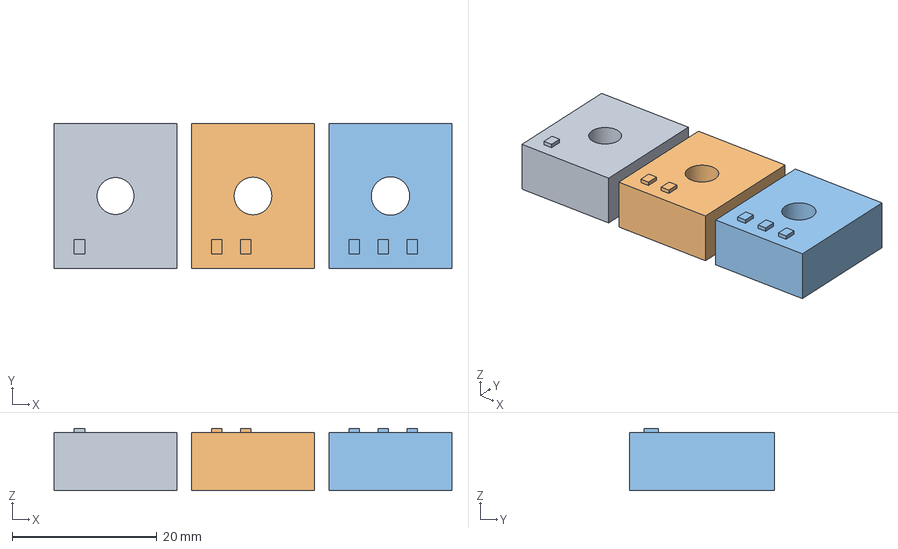
[picture p26: CAD file, 2026-11-06]
cad/reference_v13/carriage_v3/09_shaft_fit_test.step
55.0 x 20.0 x 8.60 mm
