jerrekt/Bricked-Sorting/cad/reference_v13/deck_v13/62_led_bar_holder_PRINT_2.step

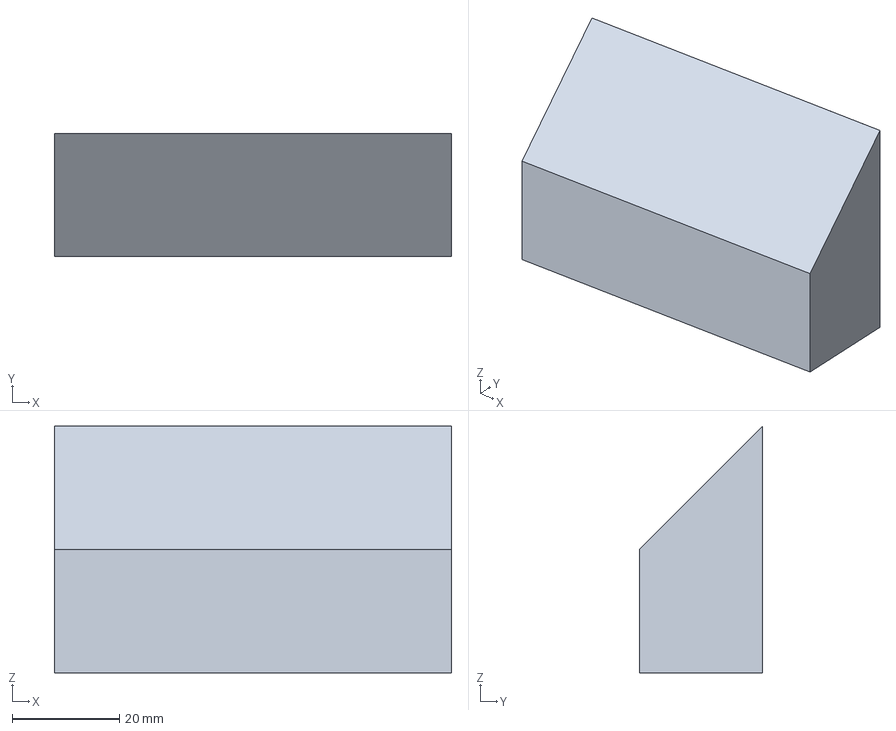
[picture p27: CAD file, 2026-11-06]
cad/reference_v13/deck_v13/62_led_bar_holder_PRINT_2.step
74.0 x 23.0 x 46.0 mm
