jerrekt/Bricked-Sorting/cad/reference_v13/frame_v13/77_2020_three_way_corner_PRINT_8.step

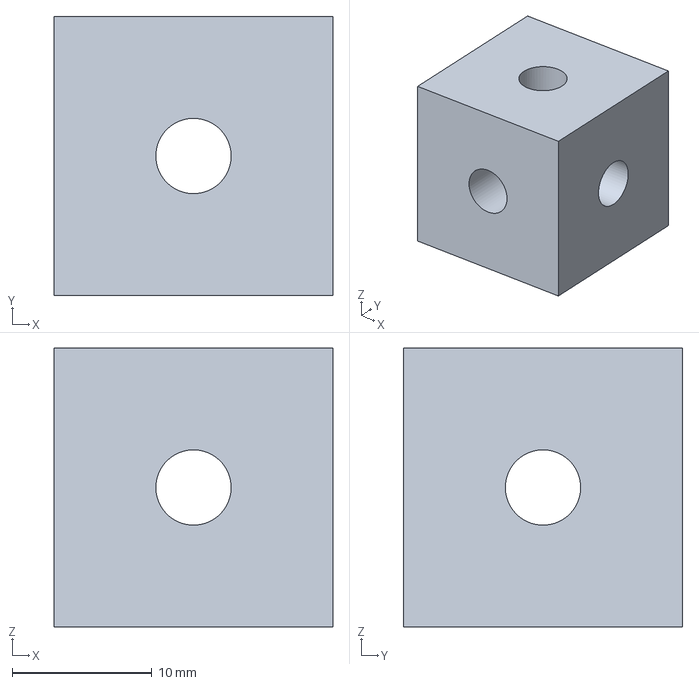
[picture p28: CAD file, 2026-11-06]
cad/reference_v13/frame_v13/77_2020_three_way_corner_PRINT_8.step
20.0 x 20.0 x 20.0 mm
