jerrekt/Bricked-Sorting/cad/v14/frame/print/117_panel_keeper_top_x-150_PRINT_1.stl

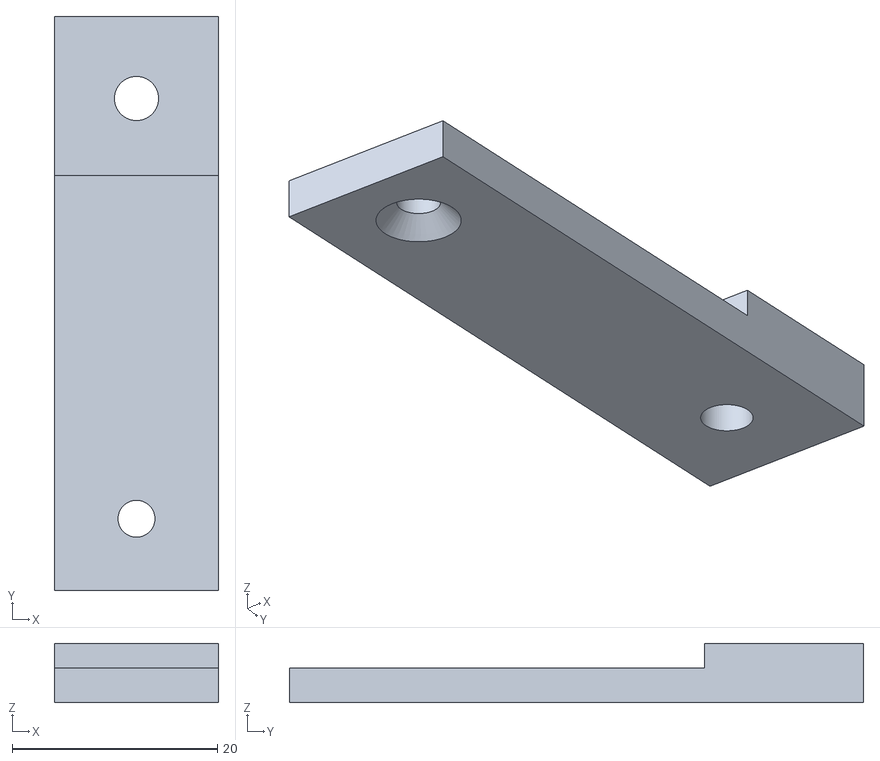
[picture p29: CAD file, 2026-11-09]
cad/v14/frame/print/117_panel_keeper_top_x-150_PRINT_1.stl
16.0 x 56.0 x 5.80
