jerrekt/Bricked-Sorting/cad/v14/frame/world/120_clip_C1_R_112.step

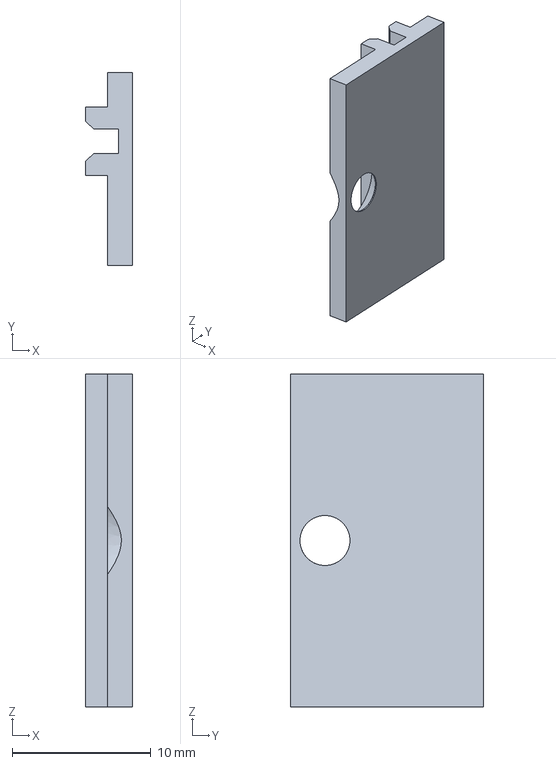
[picture p30: CAD file, 2026-11-10]
cad/v14/frame/world/120_clip_C1_R_112.step
3.40 x 13.9 x 24.0 mm
