jerrekt/Bricked-Sorting/cad/reference_v13/carriage_v3/01_ground_base.step

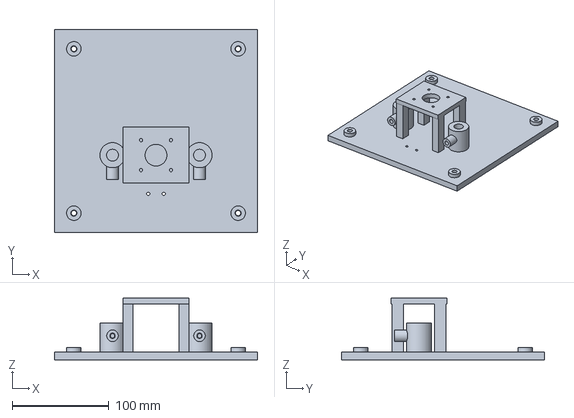
[picture p31: CAD file, 2026-11-06]
cad/reference_v13/carriage_v3/01_ground_base.step
210.0 x 210.0 x 64.0 mm
