jerrekt/Bricked-Sorting/cad/reference_v13/deck_v13/53_drum_motor_bridge.step

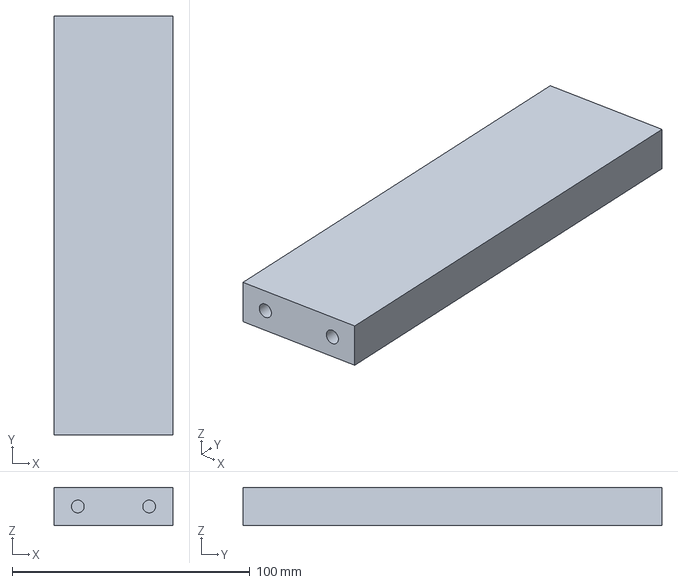
[picture p32: CAD file, 2026-11-06]
cad/reference_v13/deck_v13/53_drum_motor_bridge.step
50.0 x 176.0 x 16.0 mm
