jerrekt/Bricked-Sorting/cad/reference_v13/frame_v13/75c_latch_catch_PRINT_2.step

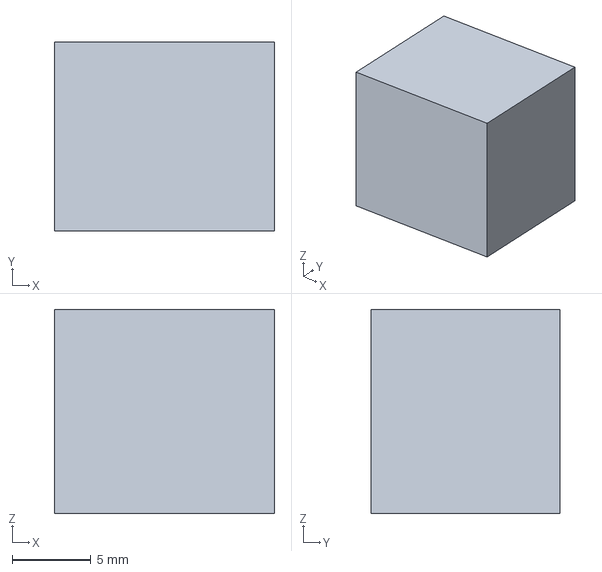
[picture p33: CAD file, 2026-11-06]
cad/reference_v13/frame_v13/75c_latch_catch_PRINT_2.step
14.0 x 12.0 x 13.0 mm
