jerrekt/Bricked-Sorting/cad/reference_v13/carriage_v3/02_moving_carriage_v3.step

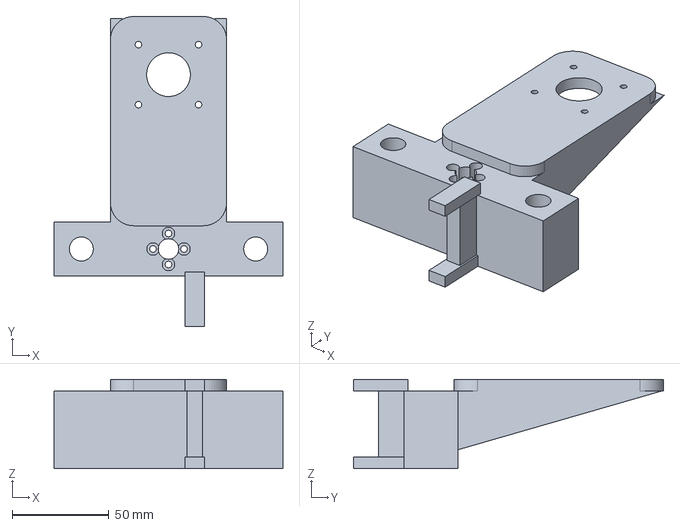
[picture p34: CAD file, 2026-11-06]
cad/reference_v13/carriage_v3/02_moving_carriage_v3.step
118.0 x 160.0 x 46.0 mm
