jerrekt/Bricked-Sorting/cad/reference_v13/deck_v13/59_door_link_PRINT_2.step

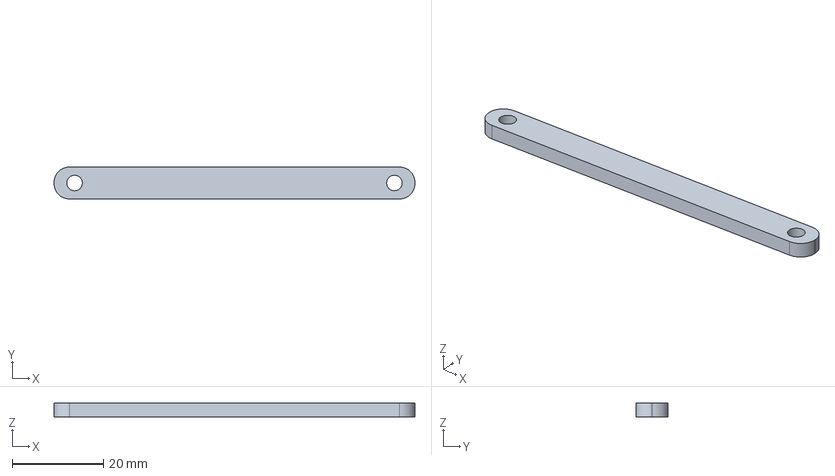
[picture p35: CAD file, 2026-11-06]
cad/reference_v13/deck_v13/59_door_link_PRINT_2.step
79.0 x 7.00 x 3.00 mm
