jerrekt/Bricked-Sorting/cad/reference_v13/frame_v13/78_stud_ring_quarter_PRINT_8.step

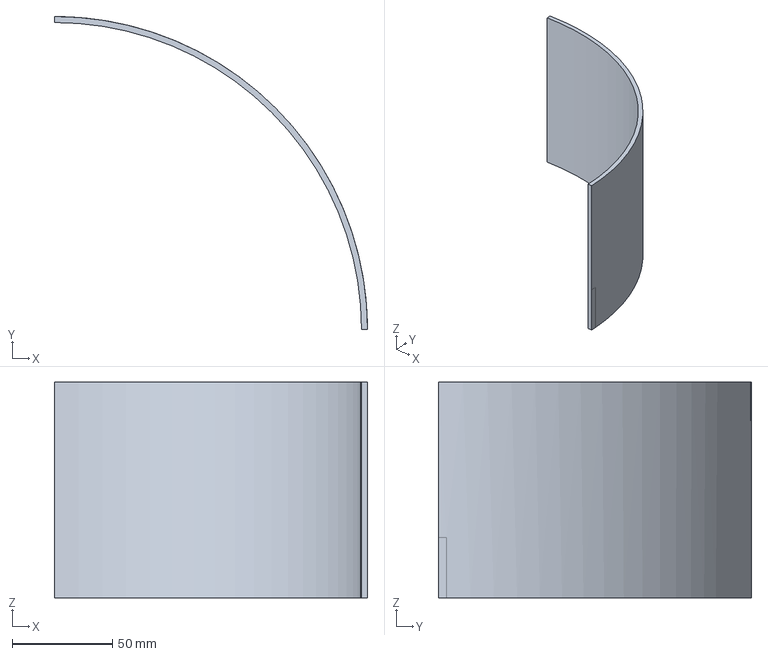
[picture p36: CAD file, 2026-11-06]
cad/reference_v13/frame_v13/78_stud_ring_quarter_PRINT_8.step
156.0 x 156.0 x 107.5 mm
