jerrekt/Bricked-Sorting/cad/v14/frame/print/116_panel_keeper_bottom_x-50_PRINT_1.stl

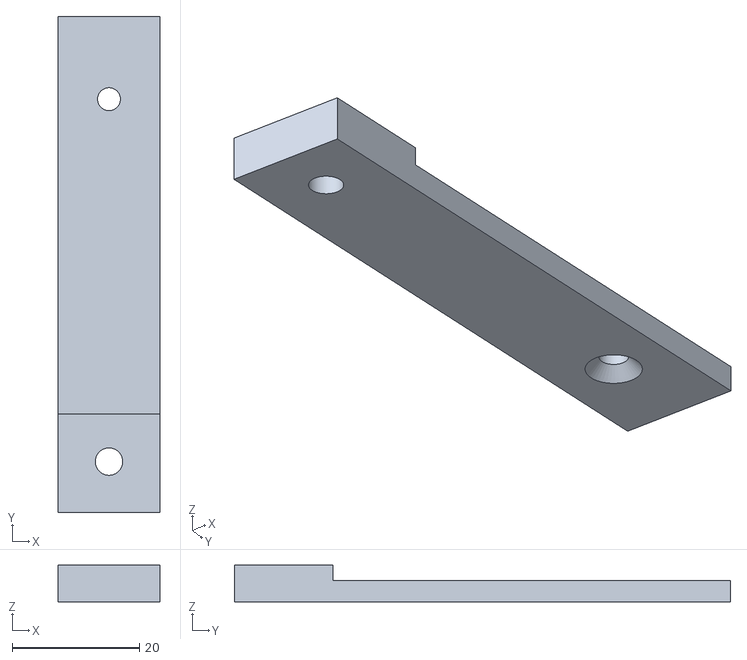
[picture p37: CAD file, 2026-11-09]
cad/v14/frame/print/116_panel_keeper_bottom_x-50_PRINT_1.stl
16.0 x 78.0 x 5.80
