jerrekt/Bricked-Sorting/cad/v14/frame/world/110_tile_F_c1_r1.step

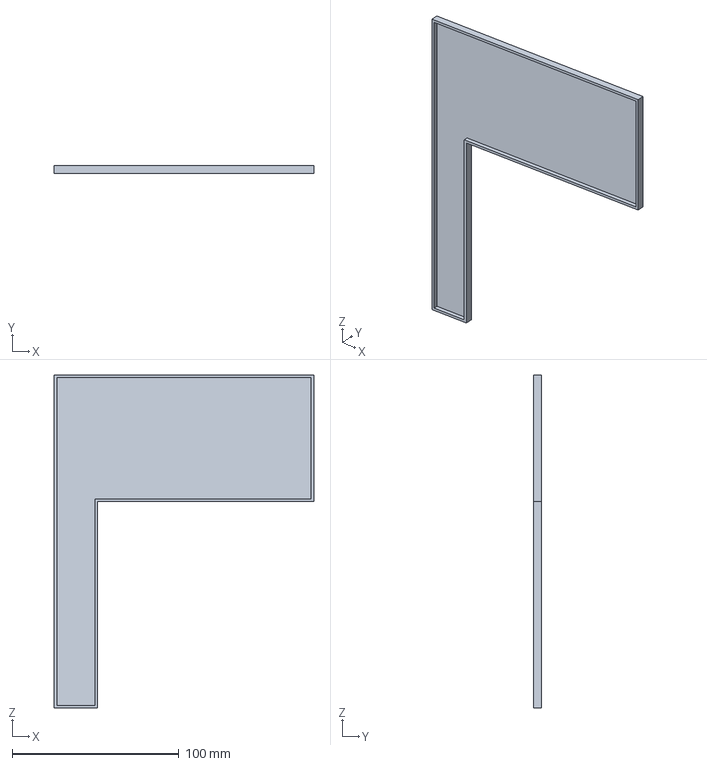
[picture p38: CAD file, 2026-11-10]
cad/v14/frame/world/110_tile_F_c1_r1.step
156.0 x 4.79 x 200.0 mm
