jerrekt/Bricked-Sorting/cad/reference_v13/carriage_v3/07_upper_switch_rod_mount.step

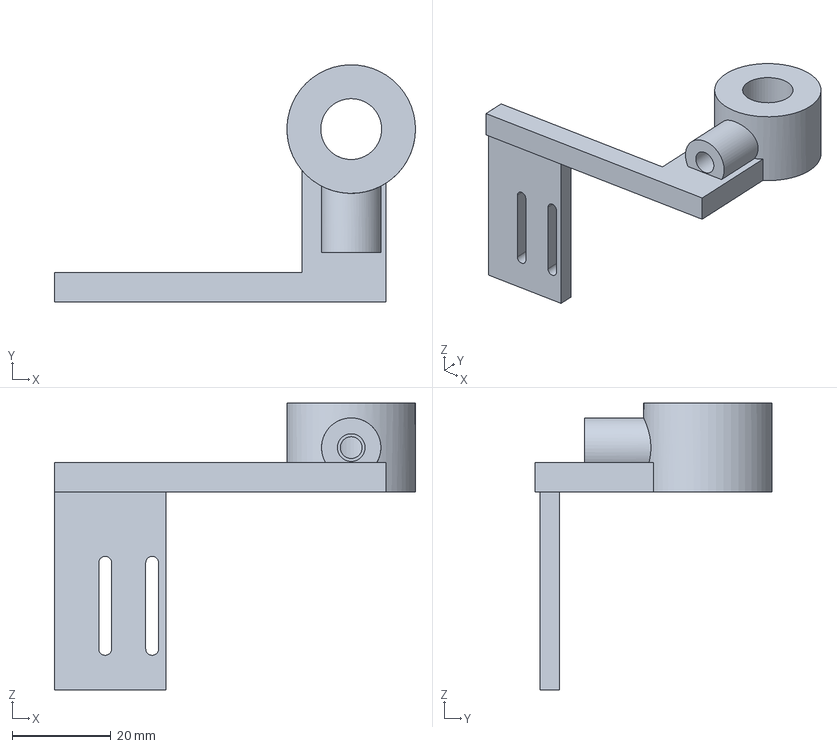
[picture p39: CAD file, 2026-11-06]
cad/reference_v13/carriage_v3/07_upper_switch_rod_mount.step
73.0 x 48.0 x 58.0 mm
