jerrekt/Bricked-Sorting/cad/reference_v13/deck_v13/56_tray_support_V2_2.step

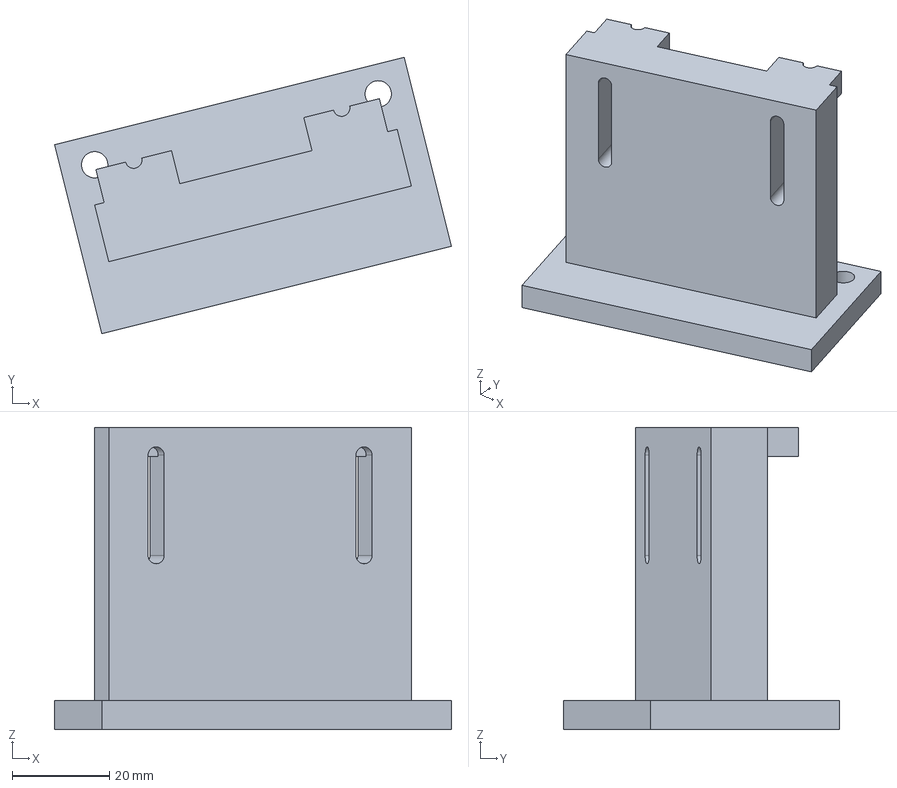
[picture p40: CAD file, 2026-11-06]
cad/reference_v13/deck_v13/56_tray_support_V2_2.step
81.5 x 56.8 x 62.0 mm
