jerrekt/Bricked-Sorting/cad/reference_v13/frame_v13/79b_loading_stud_ring_top_quarter_PRINT_4.step

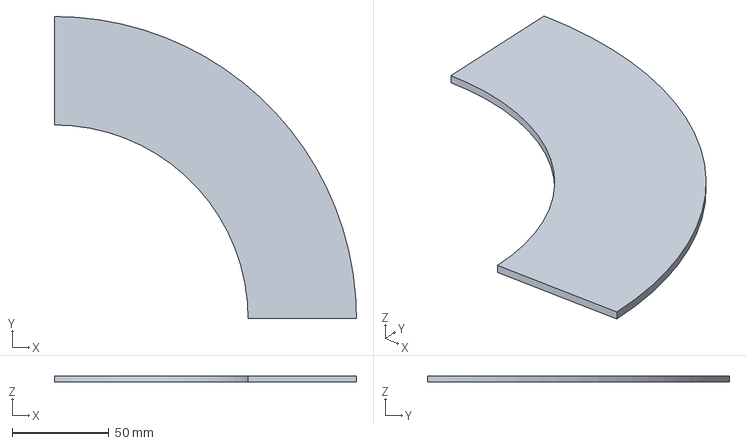
[picture p41: CAD file, 2026-11-06]
cad/reference_v13/frame_v13/79b_loading_stud_ring_top_quarter_PRINT_4.step
156.0 x 156.0 x 3.00 mm
