jerrekt/Bricked-Sorting/cad/v14/frame/world/123_clip_C3_roof_15.step

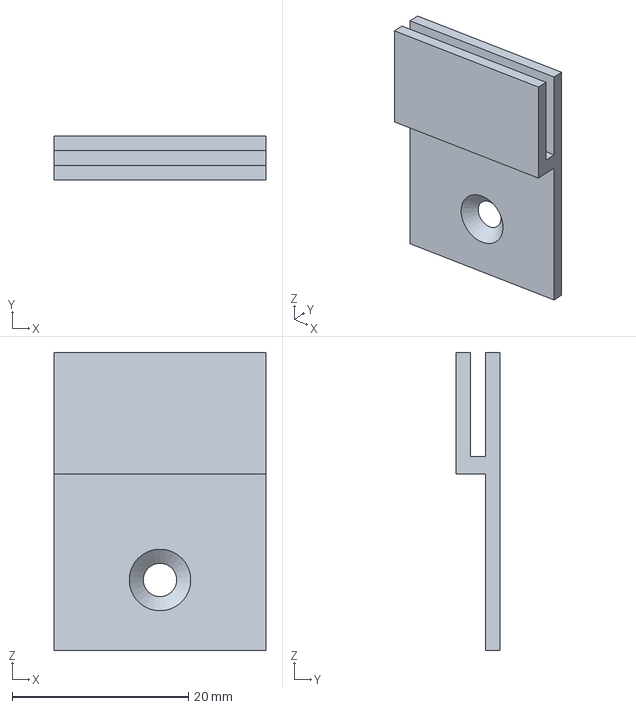
[picture p42: CAD file, 2026-11-10]
cad/v14/frame/world/123_clip_C3_roof_15.step
24.0 x 4.94 x 33.8 mm
