jerrekt/Bricked-Sorting/cad/reference_v13/carriage_v3/10_M2_switch_backer_PRINT_TWICE.step

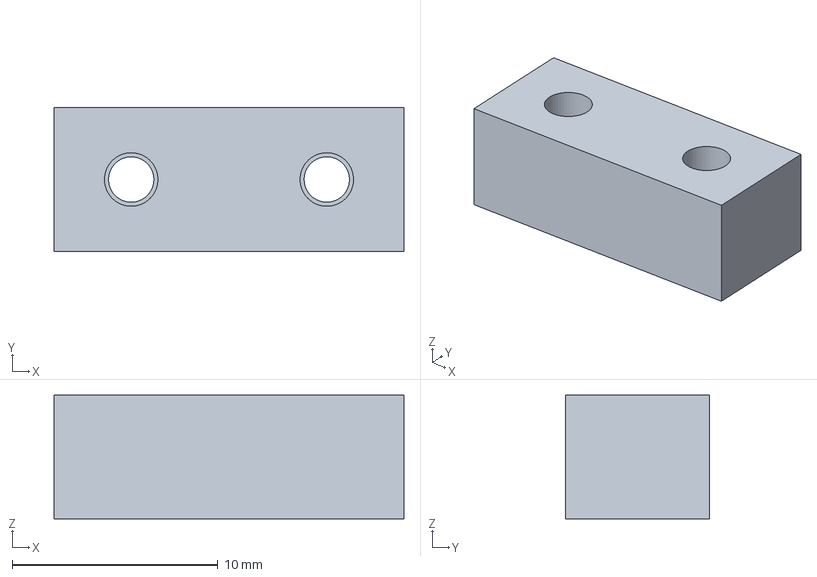
[picture p43: CAD file, 2026-11-06]
cad/reference_v13/carriage_v3/10_M2_switch_backer_PRINT_TWICE.step
17.0 x 7.00 x 6.00 mm
