jerrekt/Bricked-Sorting/cad/reference_v13/deck_v13/60_servo_horn_arm.step

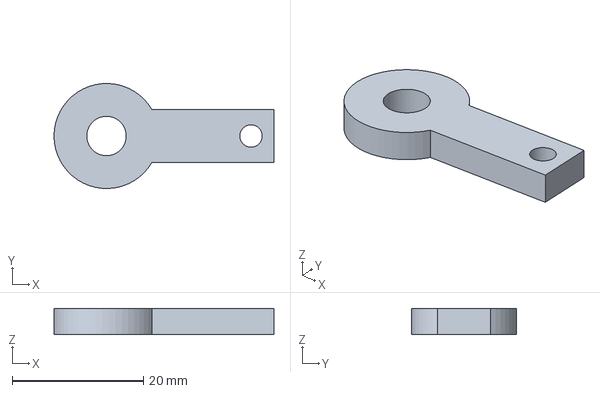
[picture p44: CAD file, 2026-11-06]
cad/reference_v13/deck_v13/60_servo_horn_arm.step
33.5 x 16.0 x 4.00 mm
