jerrekt/Bricked-Sorting/cad/reference_v13/frame_v13/75_drawer_latch_lever_PRINT_2.step

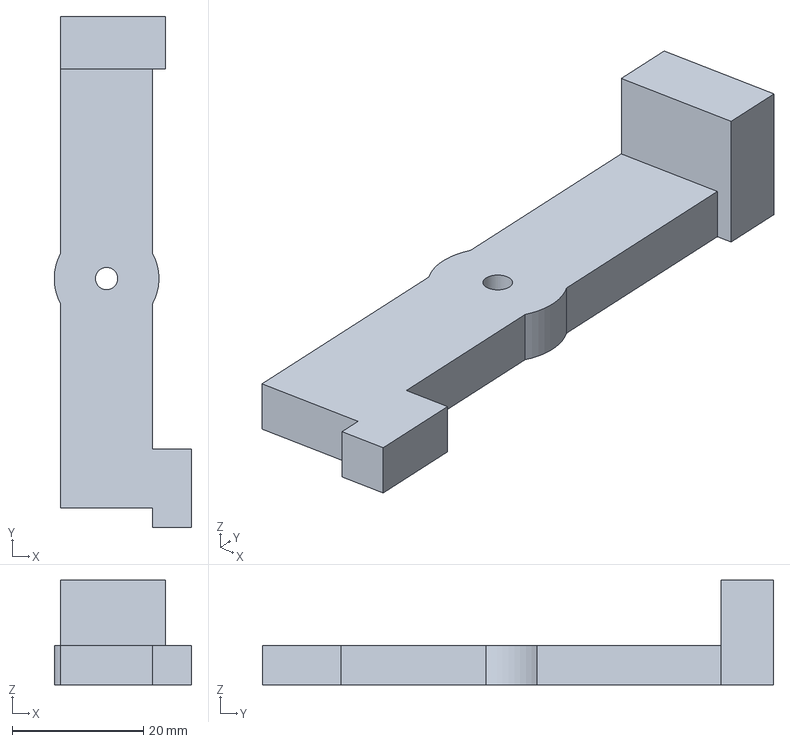
[picture p45: CAD file, 2026-11-06]
cad/reference_v13/frame_v13/75_drawer_latch_lever_PRINT_2.step
21.0 x 78.0 x 16.0 mm
