jerrekt/Bricked-Sorting/cad/v14/frame/print/111_tile_B_c1_r3_PRINT_1.stl

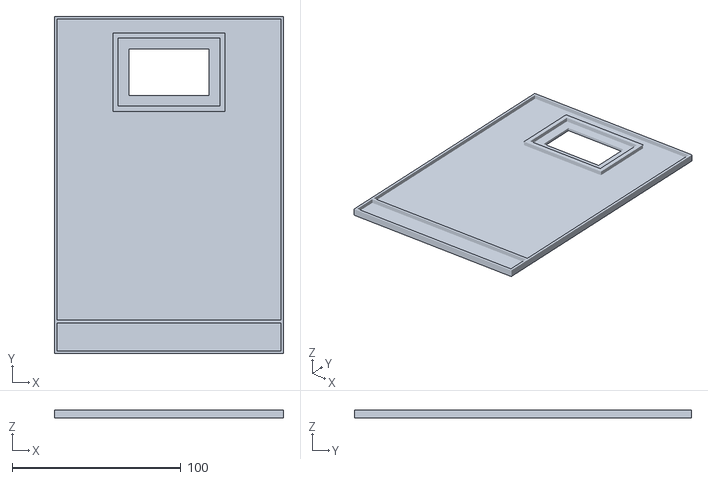
[picture p46: CAD file, 2026-11-08]
cad/v14/frame/print/111_tile_B_c1_r3_PRINT_1.stl
136.0 x 200.0 x 4.79
