jerrekt/Bricked-Sorting/cad/reference_v13/carriage_v3/03_top_rod_brace.step

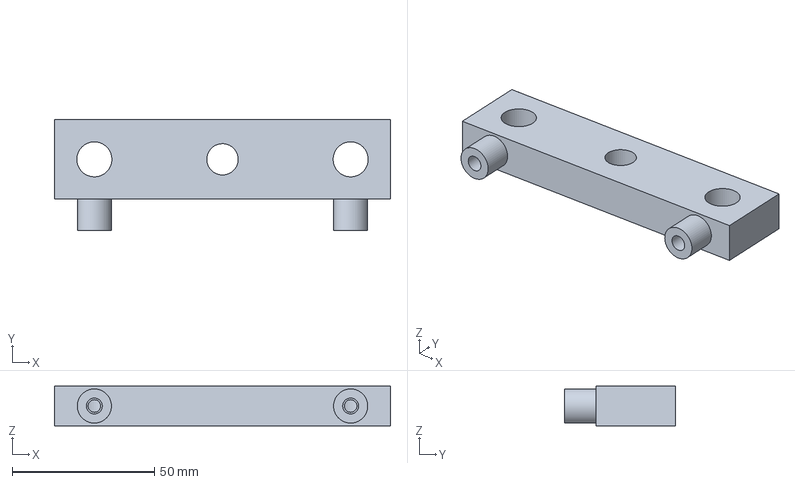
[picture p47: CAD file, 2026-11-06]
cad/reference_v13/carriage_v3/03_top_rod_brace.step
118.0 x 39.0 x 14.0 mm
