jerrekt/Bricked-Sorting/cad/reference_v13/deck_v13/54_V1_tray.step

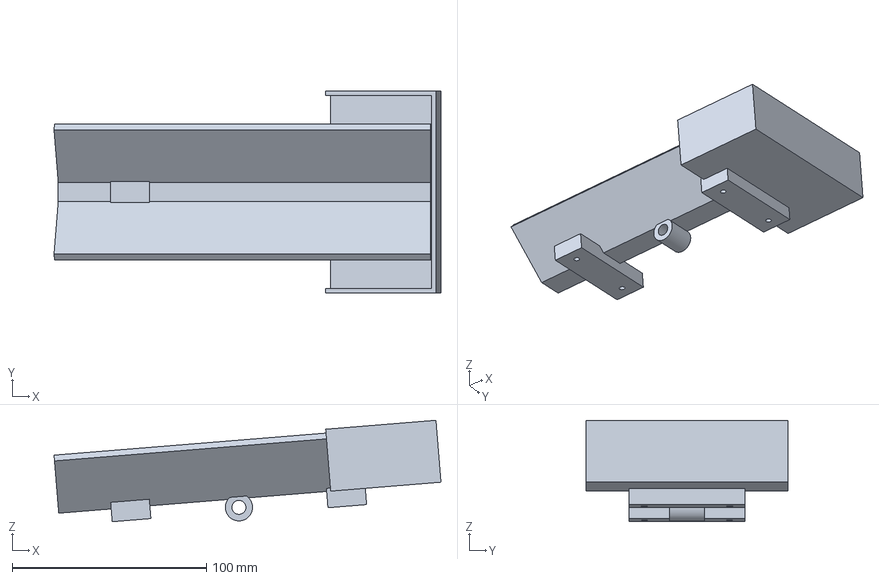
[picture p48: CAD file, 2026-11-06]
cad/reference_v13/deck_v13/54_V1_tray.step
199.4 x 104.0 x 52.3 mm
