jerrekt/Bricked-Sorting/cad/reference_v13/carriage_v3/08_rod_fit_test.step

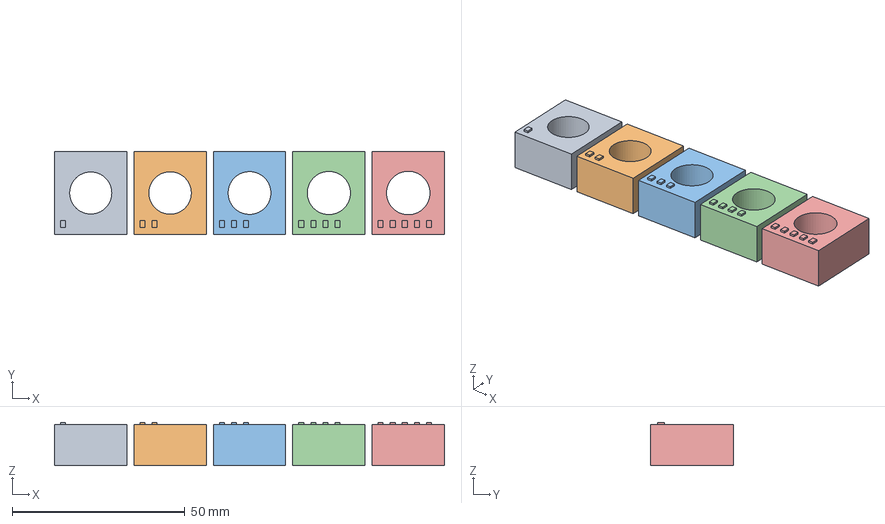
[picture p50: CAD file, 2026-11-06]
cad/reference_v13/carriage_v3/08_rod_fit_test.step
113.0 x 24.0 x 12.6 mm
