jerrekt/Bricked-Sorting/cad/reference_v13/deck_v13/57e_servo_saddle.step

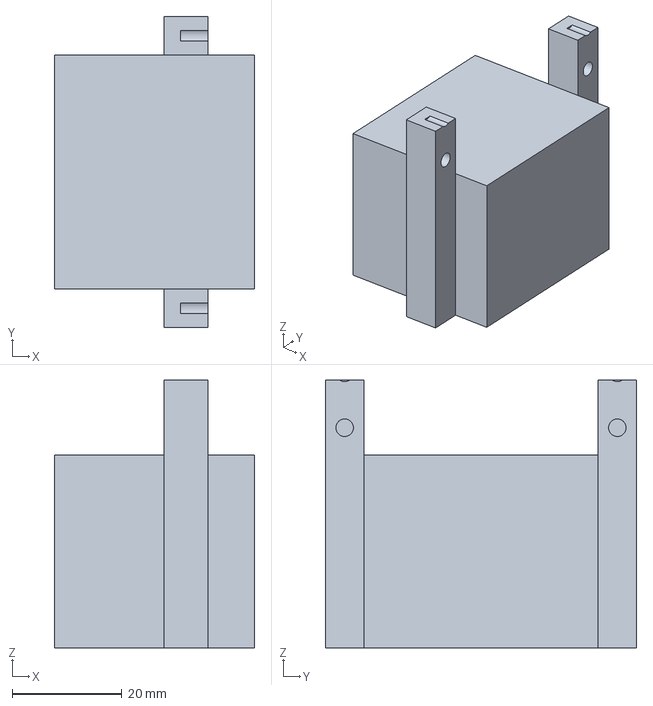
[picture p51: CAD file, 2026-11-06]
cad/reference_v13/deck_v13/57e_servo_saddle.step
36.5 x 56.7 x 48.9 mm
