jerrekt/Bricked-Sorting/cad/reference_v13/carriage_v3/06_angled_shaft_hub.step

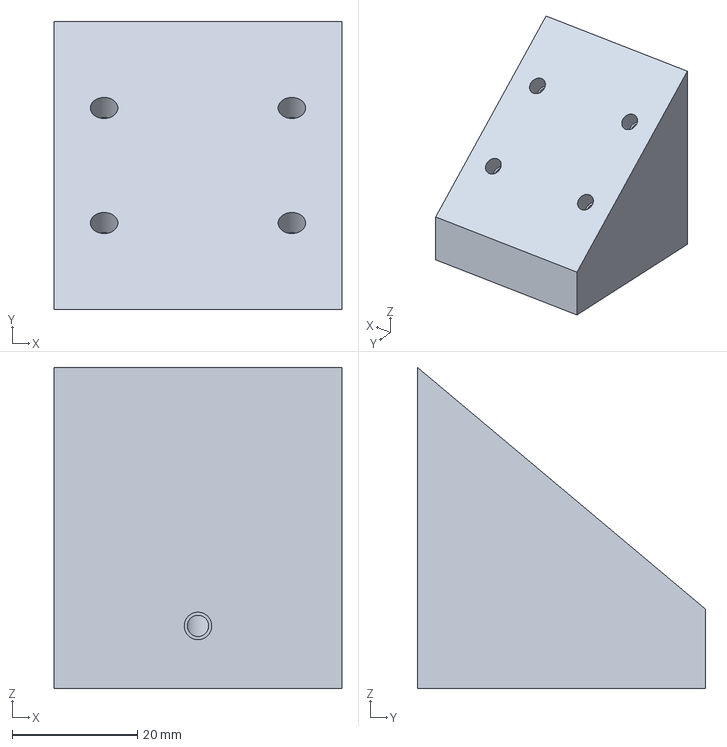
[picture p53: CAD file, 2026-11-06]
cad/reference_v13/carriage_v3/06_angled_shaft_hub.step
46.0 x 46.0 x 51.3 mm
