jerrekt/Bricked-Sorting/cad/v14/frame/world/110_tile_F_c3_r3.step

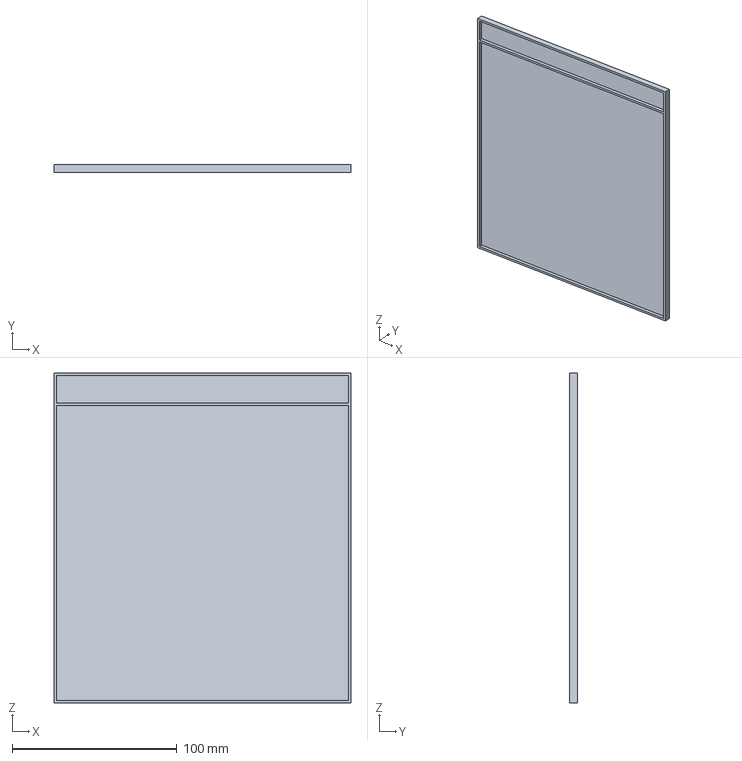
[picture p54: CAD file, 2026-11-10]
cad/v14/frame/world/110_tile_F_c3_r3.step
180.0 x 4.79 x 200.0 mm
