jerrekt/Bricked-Sorting/cad/reference_v13/deck_v13/57_scanner_plate.step

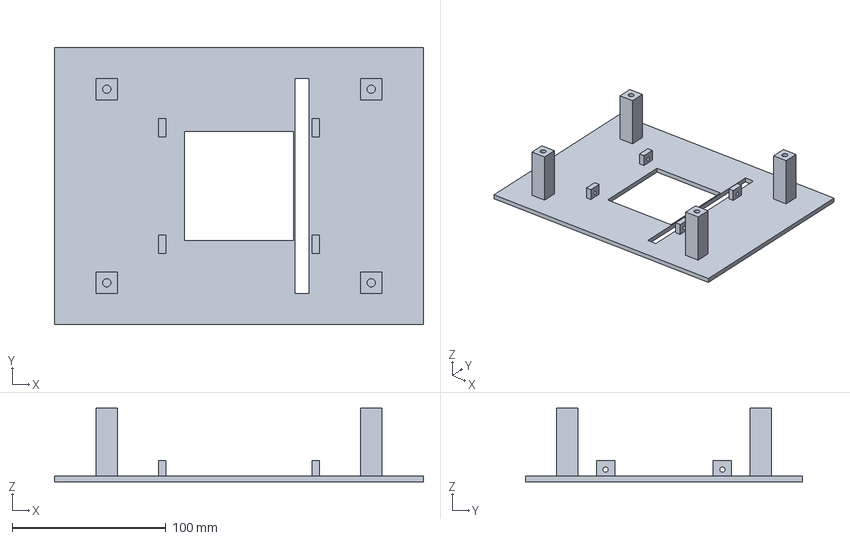
[picture p55: CAD file, 2026-11-06]
cad/reference_v13/deck_v13/57_scanner_plate.step
240.0 x 180.0 x 48.0 mm
