jerrekt/Bricked-Sorting/cad/v14/frame/print/114_roof_tile_c4_r1_PRINT_1.stl

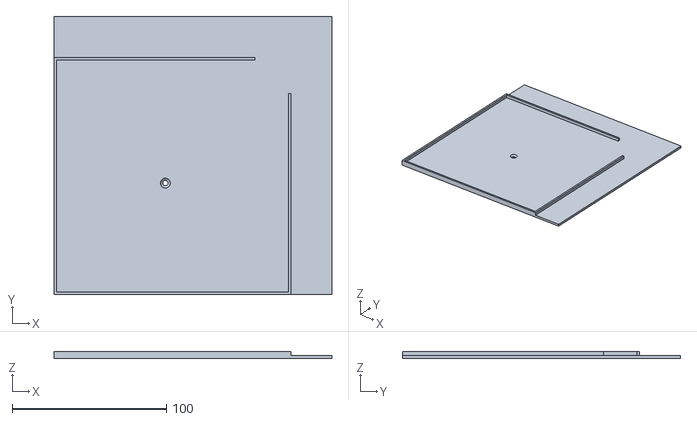
[picture p56: CAD file, 2026-11-07]
cad/v14/frame/print/114_roof_tile_c4_r1_PRINT_1.stl
180.0 x 180.0 x 4.79
