jerrekt/Bricked-Sorting/cad/v14/frame/world/121_clip_C2_L_2.step

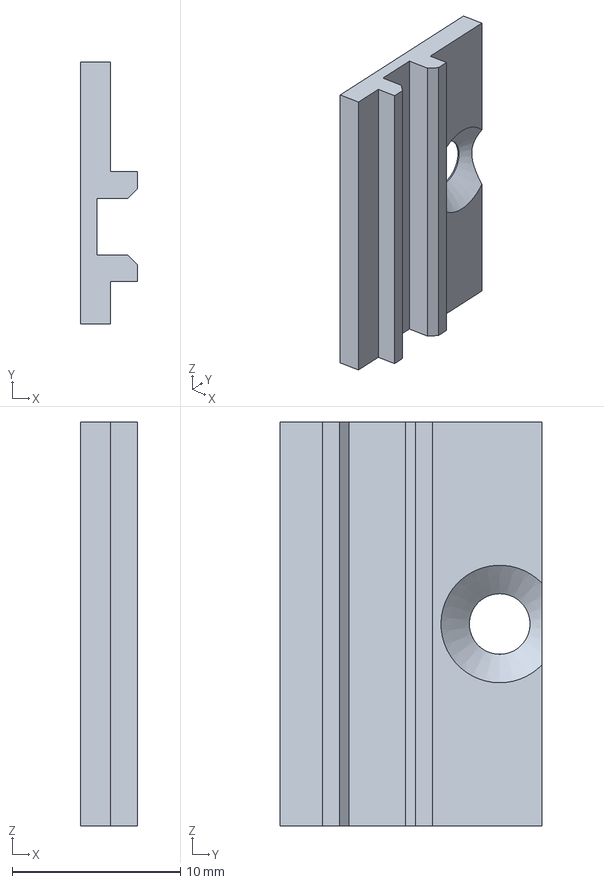
[picture p57: CAD file, 2026-11-10]
cad/v14/frame/world/121_clip_C2_L_2.step
3.40 x 15.5 x 24.0 mm
