jerrekt/Bricked-Sorting/cad/reference_v13/deck_v13/50_loading_hopper.step

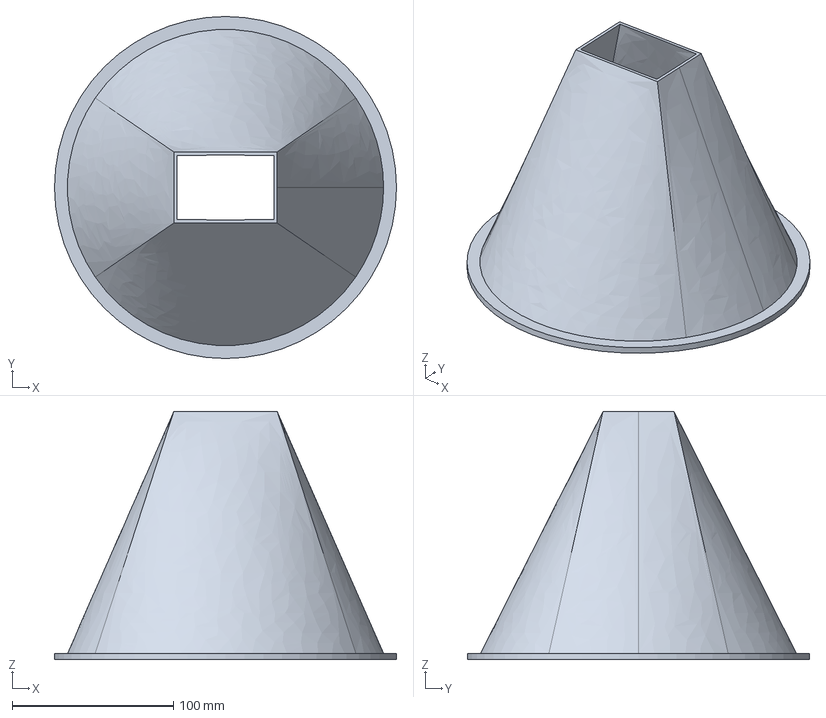
[picture p58: CAD file, 2026-11-06]
cad/reference_v13/deck_v13/50_loading_hopper.step
212.0 x 212.0 x 154.0 mm
