jerrekt/Bricked-Sorting/cad/v14/frame/print/110_tile_F_c2_r1_PRINT_1.stl

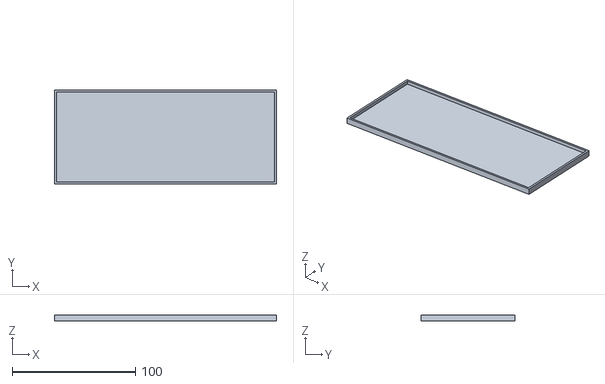
[picture p59: CAD file, 2026-11-07]
cad/v14/frame/print/110_tile_F_c2_r1_PRINT_1.stl
180.0 x 76.0 x 4.79
