jerrekt/Bricked-Sorting/cad/reference_v13/deck_v13/73_xiao_sense_camera_mount.step

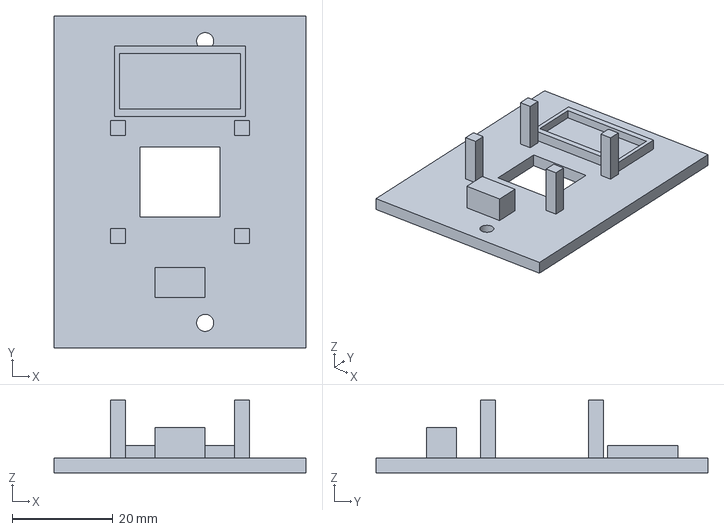
[picture p60: CAD file, 2026-11-06]
cad/reference_v13/deck_v13/73_xiao_sense_camera_mount.step
50.0 x 66.0 x 14.5 mm
