jerrekt/Bricked-Sorting/cad/v14/frame/world/111_tile_B_c2_r3.step

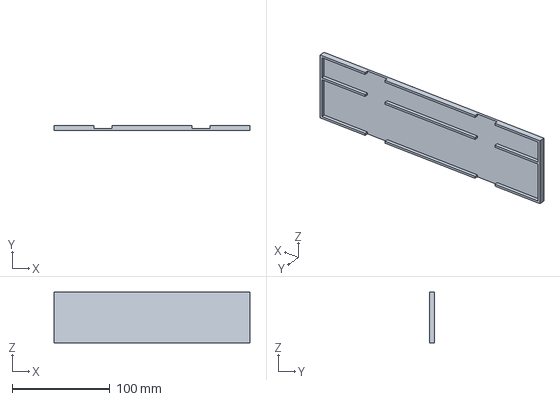
[picture p61: CAD file, 2026-11-10]
cad/v14/frame/world/111_tile_B_c2_r3.step
200.0 x 4.79 x 52.0 mm
