jerrekt/Bricked-Sorting/cad/reference_v13/deck_v13/52_drum_cradle_L.step

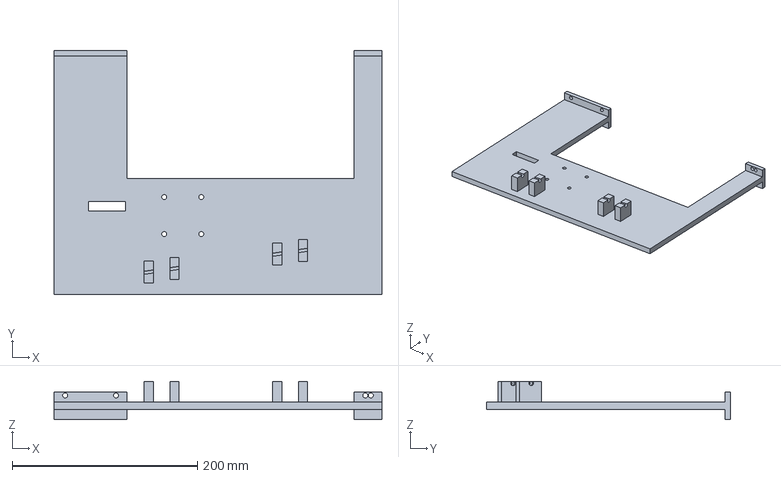
[picture p62: CAD file, 2026-11-06]
cad/reference_v13/deck_v13/52_drum_cradle_L.step
353.9 x 263.0 x 41.1 mm
