jerrekt/Bricked-Sorting/cad/v14/frame/print/114_roof_tile_c3_r2_PRINT_1.stl

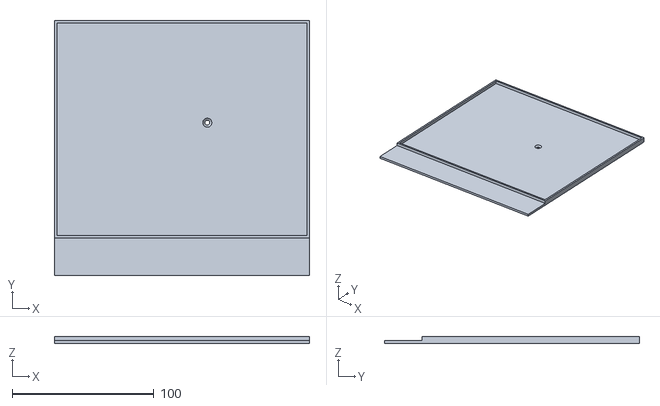
[picture p63: CAD file, 2026-11-07]
cad/v14/frame/print/114_roof_tile_c3_r2_PRINT_1.stl
180.0 x 180.0 x 4.79
