jerrekt/Bricked-Sorting/cad/reference_v13/deck_v13/57d_door_slider.step

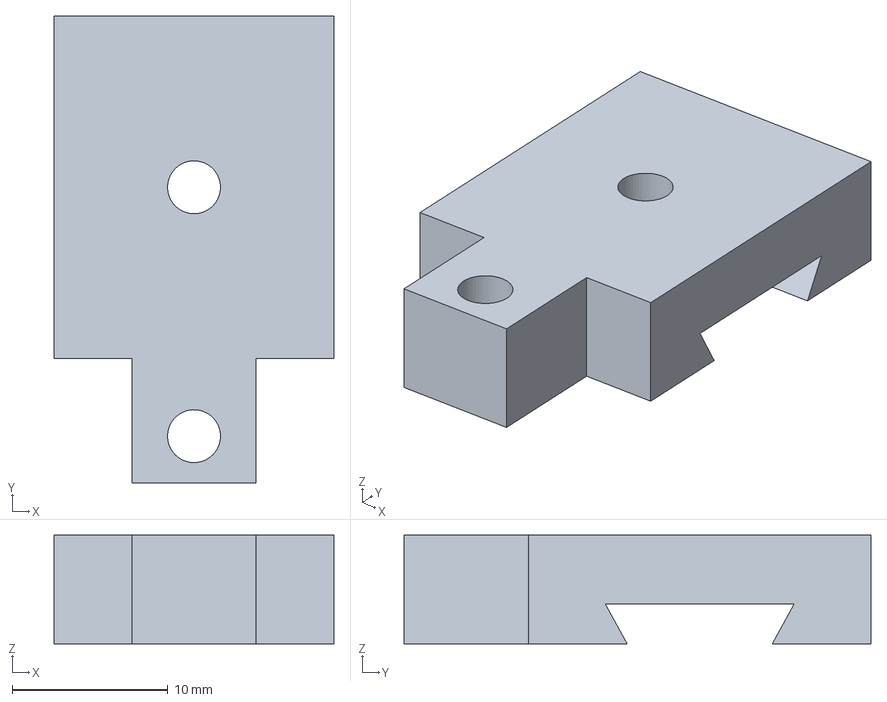
[picture p64: CAD file, 2026-11-06]
cad/reference_v13/deck_v13/57d_door_slider.step
18.0 x 30.0 x 7.00 mm
