jerrekt/Bricked-Sorting/cad/reference_v13/deck_v13/76_electronics_tray_B_PRINT.step

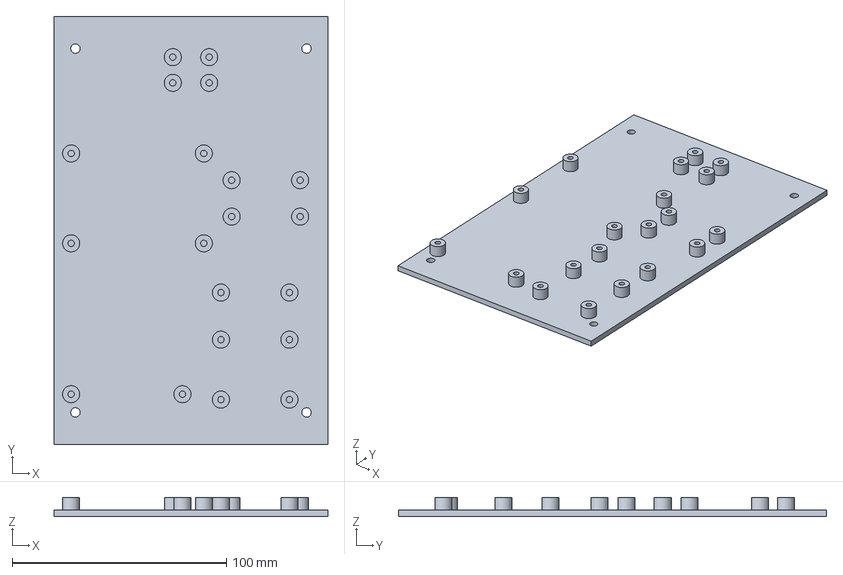
[picture p65: CAD file, 2026-11-06]
cad/reference_v13/deck_v13/76_electronics_tray_B_PRINT.step
128.0 x 200.0 x 9.00 mm
