jerrekt/Bricked-Sorting/cad/reference_v13/deck_v13/51_inlet_chute_upper.step

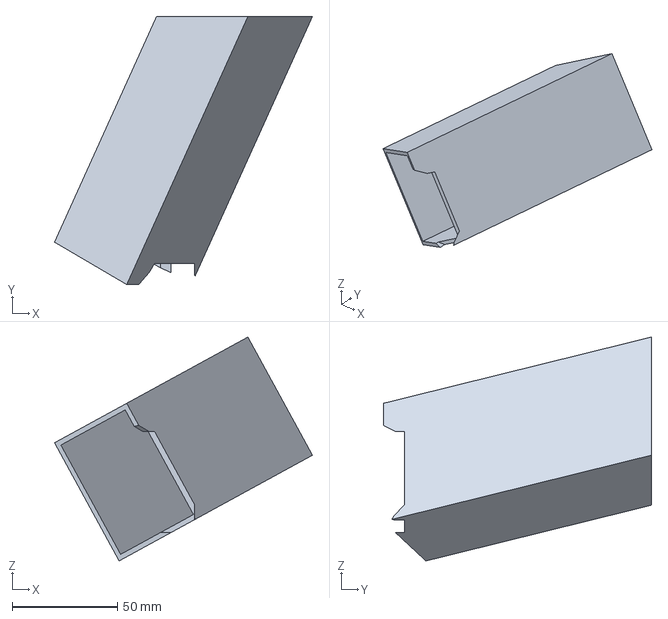
[picture p66: CAD file, 2026-11-06]
cad/reference_v13/deck_v13/51_inlet_chute_upper.step
122.6 x 127.4 x 106.4 mm
