jerrekt/Bricked-Sorting/cad/reference_v13/deck_v13/59b_servo_link.step

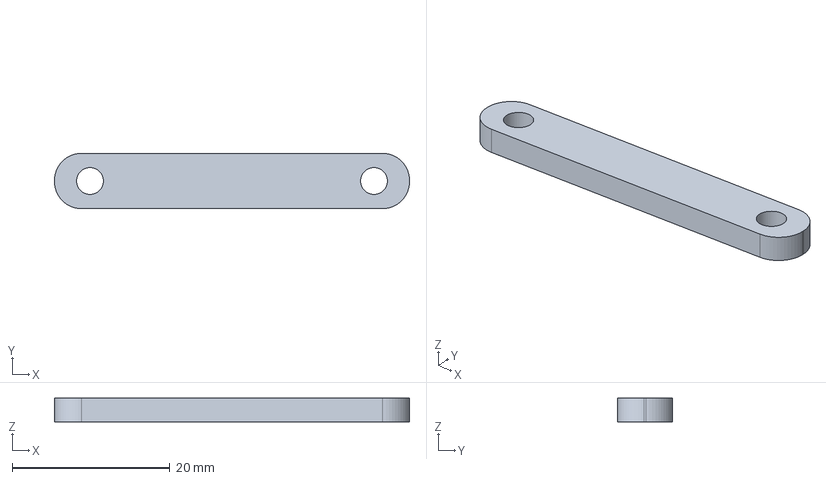
[picture p67: CAD file, 2026-11-06]
cad/reference_v13/deck_v13/59b_servo_link.step
45.0 x 7.00 x 3.00 mm
