jerrekt/Bricked-Sorting/cad/v14/frame/world/100_post_2x2_RB.step

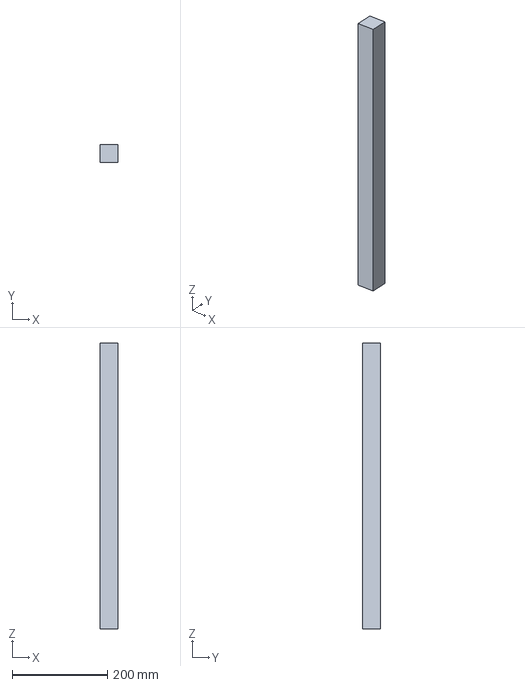
[picture p68: CAD file, 2026-11-10]
cad/v14/frame/world/100_post_2x2_RB.step
38.0 x 38.0 x 600.0 mm
