jerrekt/Bricked-Sorting/cad/reference_v13/deck_v13/61_camera_bridge.step

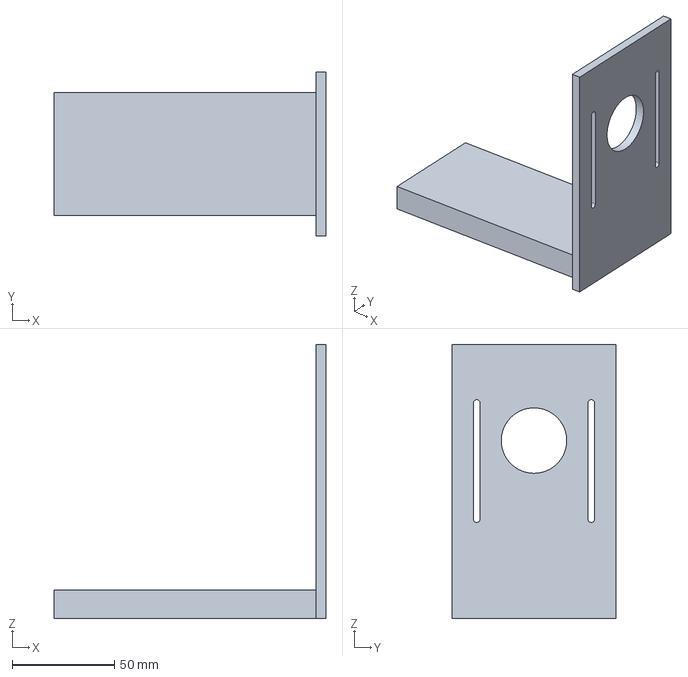
[picture p69: CAD file, 2026-11-06]
cad/reference_v13/deck_v13/61_camera_bridge.step
133.0 x 80.0 x 134.0 mm
