jerrekt/Bricked-Sorting/cad/reference_v13/deck_v13/74_apds9960_mount.step

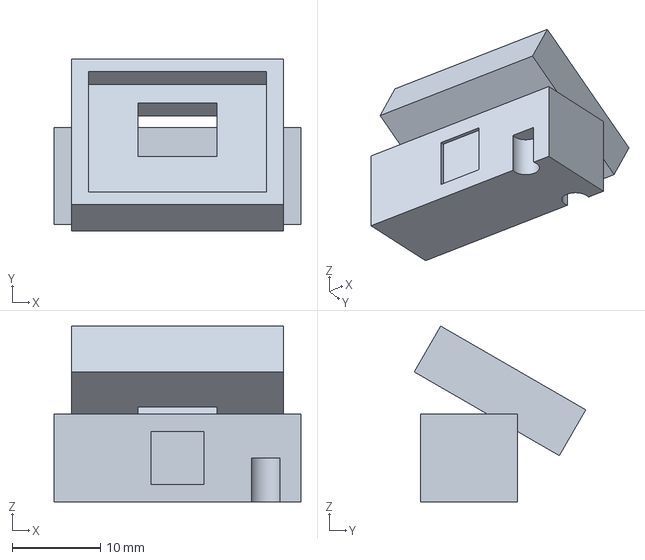
[picture p70: CAD file, 2026-11-06]
cad/reference_v13/deck_v13/74_apds9960_mount.step
28.0 x 19.5 x 19.9 mm
