jerrekt/Bricked-Sorting/cad/reference_v13/deck_v13/57c_slider_post.step

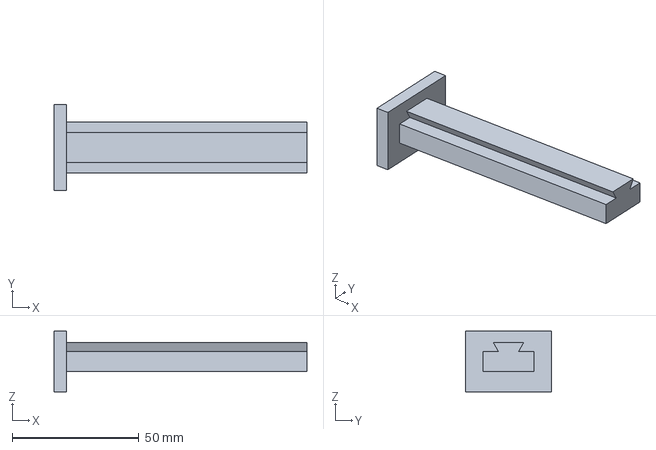
[picture p72: CAD file, 2026-11-06]
cad/reference_v13/deck_v13/57c_slider_post.step
100.0 x 34.0 x 24.0 mm
