jerrekt/Bricked-Sorting/cad/v14/frame/world/105_bottom_rail_short_R.step

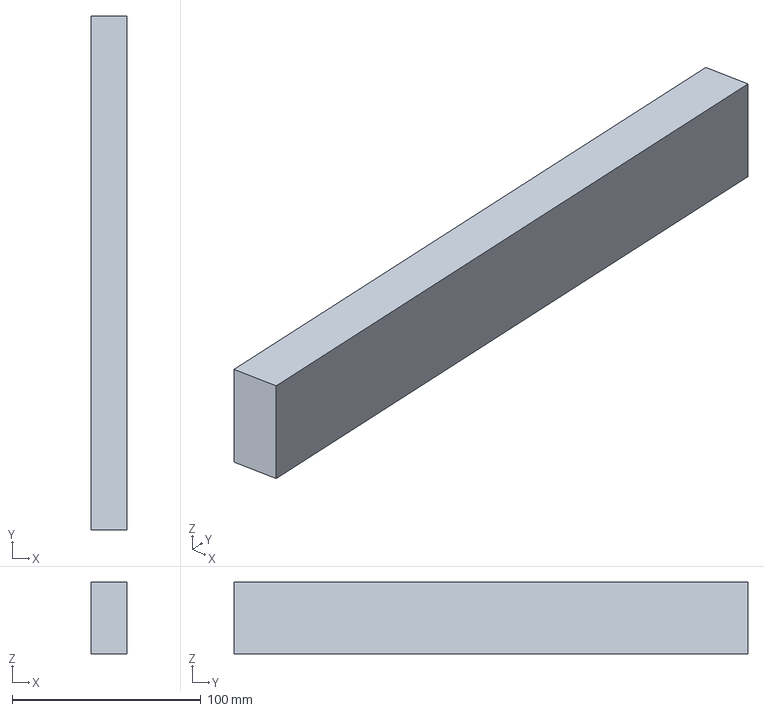
[picture p73: CAD file, 2026-11-10]
cad/v14/frame/world/105_bottom_rail_short_R.step
19.0 x 272.0 x 38.0 mm
