jerrekt/Bricked-Sorting/cad/reference_v13/deck_v13/76_electronics_tray_A_PRINT.step

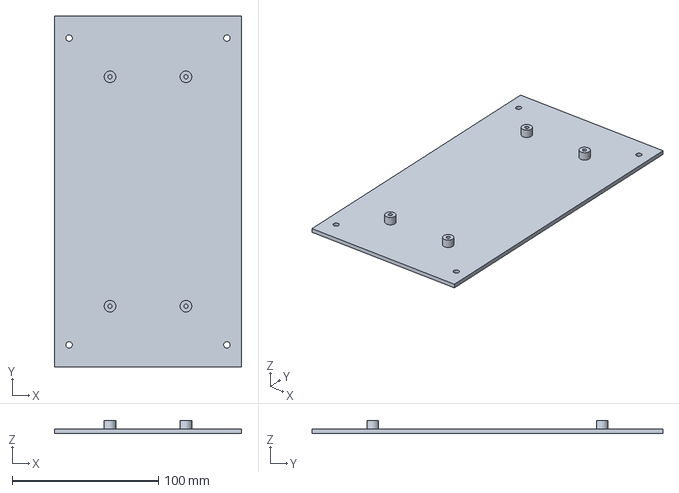
[picture p74: CAD file, 2026-11-06]
cad/reference_v13/deck_v13/76_electronics_tray_A_PRINT.step
128.0 x 240.0 x 9.00 mm
