jerrekt/Bricked-Sorting/cad/v14/frame/world/115_access_panel_x_pos.step

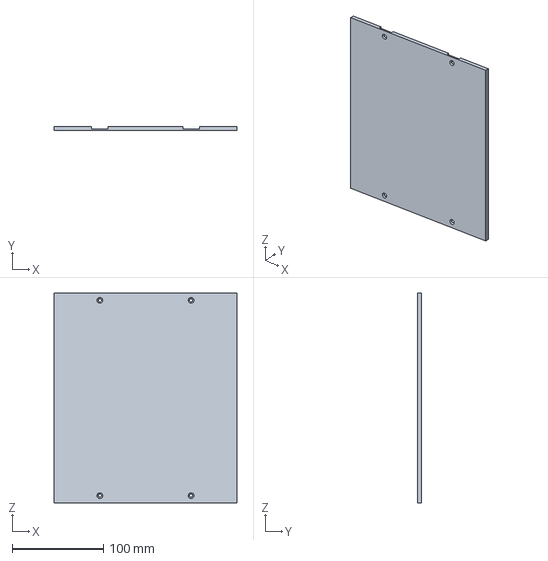
[picture p75: CAD file, 2026-11-10]
cad/v14/frame/world/115_access_panel_x_pos.step
200.0 x 4.79 x 230.0 mm
