jerrekt/Bricked-Sorting/cad/reference_v13/deck_v13/51_inlet_chute_lower.step

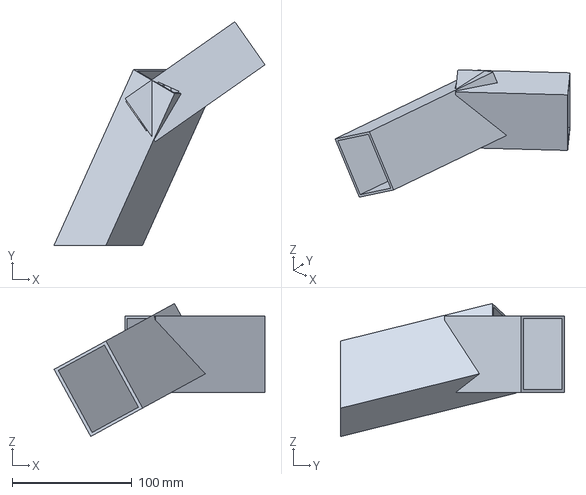
[picture p76: CAD file, 2026-11-06]
cad/reference_v13/deck_v13/51_inlet_chute_lower.step
176.4 x 187.0 x 111.2 mm
