jerrekt/Bricked-Sorting/cad/reference_v13/deck_v13/55_V2_tray.step

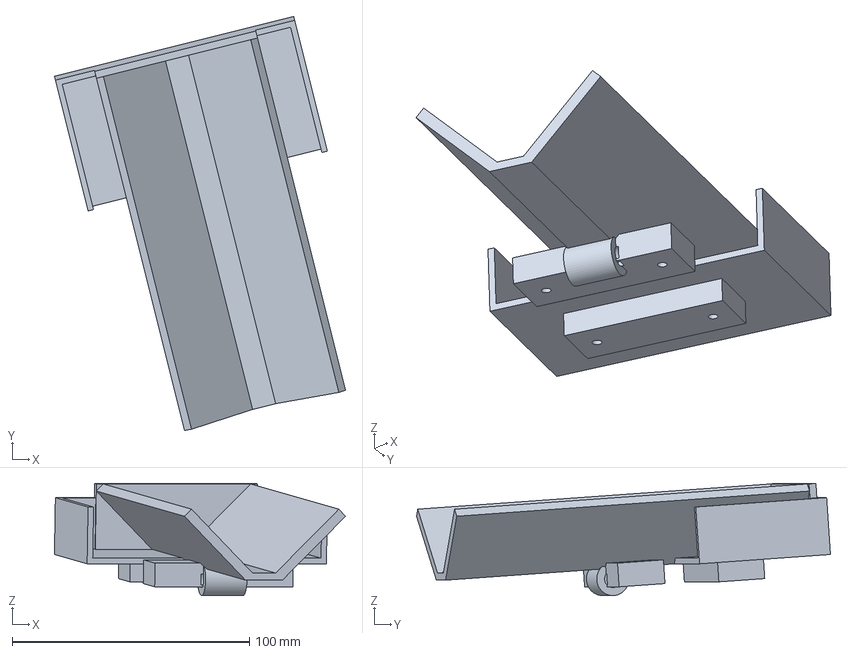
[picture p77: CAD file, 2026-11-06]
cad/reference_v13/deck_v13/55_V2_tray.step
122.8 x 174.5 x 47.2 mm
