jerrekt/Bricked-Sorting/cad/v14/frame/world/103_deck_cleat_long_F.step

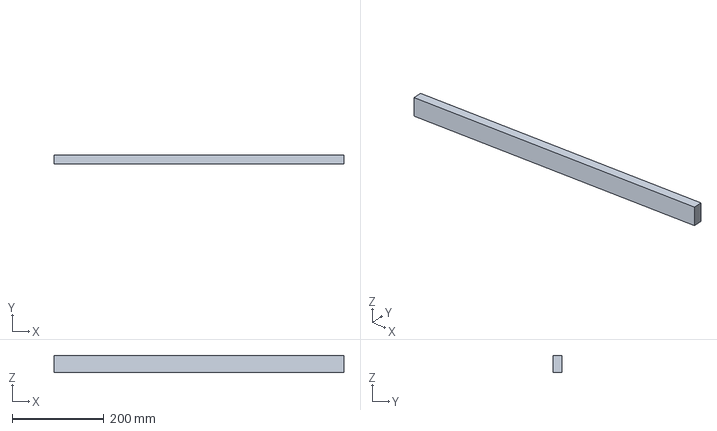
[picture p78: CAD file, 2026-11-10]
cad/v14/frame/world/103_deck_cleat_long_F.step
632.0 x 19.0 x 38.0 mm
