jerrekt/Bricked-Sorting/cad/v14/frame/print/122_clip_H_bridge_PRINT_90.stl

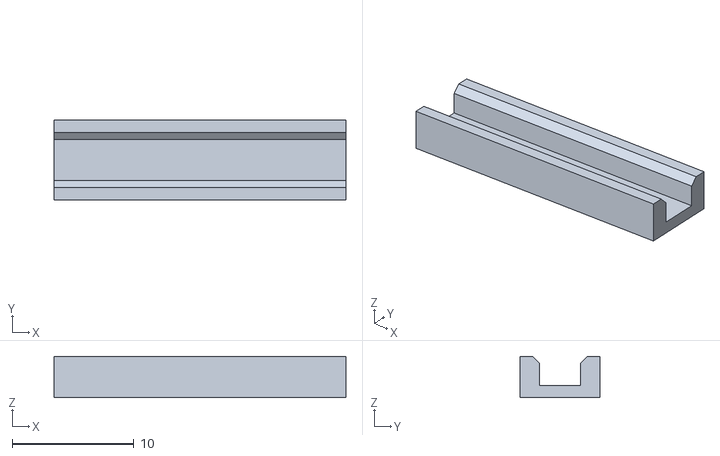
[picture p79: CAD file, 2026-11-06]
cad/v14/frame/print/122_clip_H_bridge_PRINT_90.stl
24.0 x 6.54 x 3.40
