jerrekt/Bricked-Sorting/cad/v14/frame/print/111_tile_B_c1_r2_PRINT_1.stl

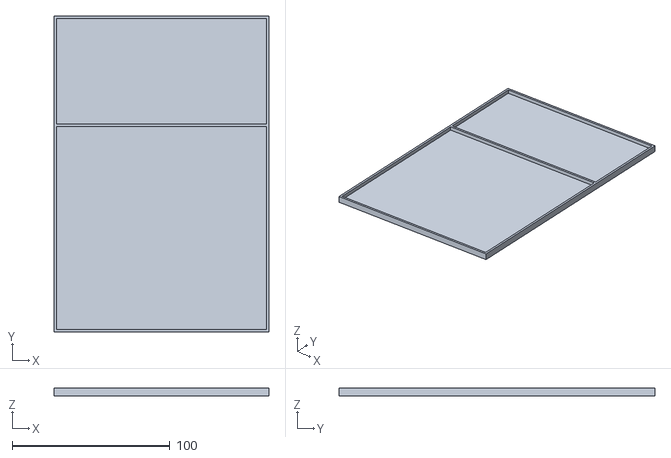
[picture p80: CAD file, 2026-11-06]
cad/v14/frame/print/111_tile_B_c1_r2_PRINT_1.stl
136.0 x 200.0 x 4.79
