jerrekt/Bricked-Sorting/(list of files, cad)

Other CAD files:
cad/reference_v13/bins_v10/41_bin_upper_PRINT_8.step
cad/v14/frame/print/117_panel_keeper_top_x-50_PRINT_1.stl
cad/v14/frame/world/120_clip_C1_L_75.step
cad/v14/frame/world/123_clip_C3_roof_1.step
cad/v14/frame/world/120_clip_C1_R_82.step
cad/v14/frame/world/120_clip_C1_L_69.step
cad/v14/frame/print/110_tile_F_c4_r1_PRINT_1.stl
cad/v14/frame/world/120_clip_C1_F_18.step
cad/v14/frame/print/114_roof_tile_c2_r2_PRINT_1.stl
cad/v14/frame/world/123_clip_C3_roof_19.step
cad/v14/frame/print/114_roof_tile_c1_r1_PRINT_1.stl
cad/v14/frame/world/120_clip_C1_R_91.step
cad/v14/frame/print/114_roof_tile_c3_r1_PRINT_1.stl
cad/v14/frame/world/120_clip_C1_R_86.step
cad/v14/frame/print/110_tile_F_c1_r1_PRINT_1.stl
cad/v14/frame/world/120_clip_C1_R_84.step
cad/v14/frame/print/110_tile_F_c3_r1_PRINT_1.stl
cad/v14/frame/print/114_roof_tile_c1_r2_PRINT_1.stl
cad/v14/frame/world/123_clip_C3_roof_6.step
cad/reference_v13/deck_v13/52_drum_cradle_R.step
cad/v14/frame/print/111_tile_B_c4_r1_PRINT_1.stl
cad/v14/frame/world/113_tile_R_c2_r3.step
cad/v14/frame/world/121_clip_C2_L_3.step
cad/v14/frame/print/114_roof_tile_c4_r2_PRINT_1.stl
cad/v14/frame/print/111_tile_B_c2_r1_PRINT_1.stl
cad/v14/frame/print/113_tile_R_c2_r1_PRINT_1.stl
cad/v14/frame/world/120_clip_C1_L_68.step
cad/v14/frame/print/135_corner_cap_LB_r2_PRINT_1.stl
cad/v14/frame/world/120_clip_C1_F_10.step
cad/v14/frame/print/135_corner_cap_RF_r3_PRINT_1.stl
cad/v14/frame/world/110_tile_F_c4_r2.step
cad/v14/frame/print/135_corner_cap_RF_r1_PRINT_1.stl
cad/v14/frame/world/117_panel_keeper_top_x-50.step
cad/v14/frame/print/112_tile_L_c2_r2_PRINT_1.stl
cad/v14/frame/world/111_tile_B_c1_r3.step
cad/v14/frame/print/120_clip_C1_single_PRINT_128.stl
cad/v14/frame/world/113_tile_R_c1_r1.step
cad/v14/frame/print/110_tile_F_c3_r3_PRINT_1.stl
cad/v14/frame/world/120_clip_C1_B_107.step
cad/v14/frame/print/120_clip_C1_single_PRINT_152.stl
cad/v14/frame/world/120_clip_C1_L_77.step
cad/v14/frame/print/113_tile_R_c1_r3_PRINT_1.stl
cad/v14/frame/world/120_clip_C1_R_116.step
cad/v14/frame/print/135_corner_cap_LB_r3_PRINT_1.stl
cad/v14/frame/world/111_tile_B_c2_r1.step
cad/v14/frame/print/112_tile_L_c2_r3_PRINT_1.stl
cad/v14/frame/world/116_panel_keeper_bottom_x-50.step
cad/v14/frame/world/120_clip_C1_F_123.step
cad/v14/frame/print/110_tile_F_c4_r3_PRINT_1.stl
cad/v14/frame/world/111_tile_B_c4_r2.step
cad/v14/frame/print/135_corner_cap_RB_r2_PRINT_1.stl
cad/v14/frame/world/120_clip_C1_B_109.step
cad/v14/frame/print/112_tile_L_c1_r2_PRINT_1.stl
cad/v14/frame/world/121_clip_C2_R_4.step
cad/v14/frame/print/121_clip_C2_seam_PRINT_6.stl
cad/v14/frame/world/111_tile_B_c1_r1.step
cad/v14/frame/print/110_tile_F_c4_r2_PRINT_1.stl
cad/v14/frame/world/123_clip_C3_roof_16.step
cad/v14/frame/print/113_tile_R_c1_r1_PRINT_1.stl
cad/v14/frame/world/112_tile_L_c2_r3.step
cad/v14/frame/world/120_clip_C1_F_17.step
cad/v14/frame/print/135_corner_cap_RF_r2_PRINT_1.stl
cad/v14/frame/world/114_roof_tile_c4_r1.step
cad/v14/frame/print/115_access_panel_x_neg_PRINT_1.stl
cad/v14/frame/world/114_roof_tile_c4_r2.step
cad/v14/frame/print/110_tile_F_c2_r2_PRINT_1.stl
cad/v14/frame/world/120_clip_C1_F_23.step
cad/v14/frame/print/135_corner_cap_RB_r1_PRINT_1.stl
cad/v14/frame/world/120_clip_C1_F_27.step
cad/v14/frame/print/111_tile_B_c4_r3_PRINT_1.stl
cad/v14/frame/world/120_clip_C1_B_40.step
cad/v14/frame/print/111_tile_B_c4_r2_PRINT_1.stl
cad/v14/frame/world/120_clip_C1_F_16.step
cad/v14/frame/print/111_tile_B_c3_r3_PRINT_1.stl
cad/v14/frame/world/120_clip_C1_F_15.step
cad/v14/frame/print/110_tile_F_c1_r3_PRINT_1.stl
cad/v14/frame/world/120_clip_C1_F_28.step
cad/reference_v13/deck_v13/56_tray_support_V1_0.step
cad/reference_v13/drum_v7/48_drum_rear_feed_guard.step
cad/reference_v13/drum_v7/50_drum_625_bearing_roller.step
cad/reference_v13/drum_v7/54_drum_drive_core_5mm.step
cad/reference_v13/drum_v7/55_drum_friction_tire_TPU.step
cad/reference_v13/drum_v7/56_drum_NEMA17_adjustable_bracket.step
cad/reference_v13/drum_v7/58_stationary_intake_to_drum_chute.step
cad/reference_v13/drum_v7/59_V1_catch_and_vibration_tray.step
cad/reference_v13/drum_v7/60_V2_vibration_tray.step
cad/reference_v13/drum_v7/62_24mm_vibration_motor_saddle.step
cad/reference_v13/drum_v7/63_24mm_vibration_motor_cap.step
cad/v14/frame/print/110_tile_F_c1_r2_PRINT_1.stl
cad/v14/frame/print/110_tile_F_c2_r3_PRINT_1.stl
cad/v14/frame/print/110_tile_F_c3_r2_PRINT_1.stl
cad/v14/frame/print/111_tile_B_c2_r3_PRINT_1.stl
cad/v14/frame/print/112_tile_L_c1_r1_PRINT_1.stl
cad/v14/frame/print/112_tile_L_c1_r3_PRINT_1.stl
cad/v14/frame/print/112_tile_L_c2_r1_PRINT_1.stl
cad/v14/frame/print/113_tile_R_c1_r2_PRINT_1.stl
cad/v14/frame/print/113_tile_R_c2_r2_PRINT_1.stl
cad/v14/frame/print/113_tile_R_c2_r3_PRINT_1.stl
cad/v14/frame/print/115_access_panel_x_pos_PRINT_1.stl
cad/v14/frame/print/117_panel_keeper_top_x50_PRINT_1.stl
cad/v14/frame/print/121_clip_C2_seam_PRINT_12.stl
cad/v14/frame/print/123_clip_C3_roof_PRINT_24.stl
cad/v14/frame/print/135_corner_cap_LB_r1_PRINT_1.stl
cad/v14/frame/print/135_corner_cap_LF_r1_PRINT_1.stl
cad/v14/frame/print/135_corner_cap_LF_r2_PRINT_1.stl
cad/v14/frame/print/135_corner_cap_LF_r3_PRINT_1.stl
cad/v14/frame/print/135_corner_cap_RB_r3_PRINT_1.stl
cad/v14/frame/world/100_post_2x2_LB.step
cad/v14/frame/world/100_post_2x2_LF.step
cad/v14/frame/world/100_post_2x2_RF.step
cad/v14/frame/world/101_top_rail_long_B.step
cad/v14/frame/world/101_top_rail_long_F.step
cad/v14/frame/world/102_top_rail_short_L.step
cad/v14/frame/world/102_top_rail_short_R.step
cad/v14/frame/world/103_deck_cleat_long_B.step
cad/v14/frame/world/104_deck_cleat_short_L.step
cad/v14/frame/world/104_deck_cleat_short_R.step
cad/v14/frame/world/105_bottom_rail_short_L.step
cad/v14/frame/world/106_beam_post_L.step
cad/v14/frame/world/106_beam_post_R.step
cad/v14/frame/world/107_floor_ply.step
cad/v14/frame/world/108_deck_ply.step
cad/v14/frame/world/109_roof_cross_rail_1.step
cad/v14/frame/world/109_roof_cross_rail_2.step
cad/v14/frame/world/110_tile_F_c1_r2.step
cad/v14/frame/world/110_tile_F_c1_r3.step
cad/v14/frame/world/110_tile_F_c2_r1.step
cad/v14/frame/world/110_tile_F_c2_r2.step
cad/v14/frame/world/110_tile_F_c2_r3.step
cad/v14/frame/world/110_tile_F_c3_r1.step
cad/v14/frame/world/110_tile_F_c3_r2.step
cad/v14/frame/world/110_tile_F_c4_r1.step
cad/v14/frame/world/110_tile_F_c4_r3.step
cad/v14/frame/world/111_tile_B_c1_r2.step
cad/v14/frame/world/111_tile_B_c2_r2.step
cad/v14/frame/world/111_tile_B_c3_r1.step
cad/v14/frame/world/111_tile_B_c3_r2.step
cad/v14/frame/world/111_tile_B_c3_r3.step
cad/v14/frame/world/111_tile_B_c4_r1.step
cad/v14/frame/world/111_tile_B_c4_r3.step
cad/v14/frame/world/112_tile_L_c1_r1.step
cad/v14/frame/world/112_tile_L_c1_r2.step
cad/v14/frame/world/112_tile_L_c1_r3.step
cad/v14/frame/world/112_tile_L_c2_r1.step
cad/v14/frame/world/113_tile_R_c1_r2.step
cad/v14/frame/world/113_tile_R_c1_r3.step
cad/v14/frame/world/113_tile_R_c2_r1.step
cad/v14/frame/world/113_tile_R_c2_r2.step
cad/v14/frame/world/114_roof_tile_c1_r1.step
cad/v14/frame/world/114_roof_tile_c1_r2.step
cad/v14/frame/world/114_roof_tile_c2_r1.step
cad/v14/frame/world/114_roof_tile_c2_r2.step
cad/v14/frame/world/114_roof_tile_c3_r1.step
cad/v14/frame/world/114_roof_tile_c3_r2.step
cad/v14/frame/world/115_access_panel_x_neg.step
cad/v14/frame/world/116_panel_keeper_bottom_x-150.step
cad/v14/frame/world/116_panel_keeper_bottom_x150.step
cad/v14/frame/world/116_panel_keeper_bottom_x50.step
cad/v14/frame/world/117_panel_keeper_top_x-150.step
cad/v14/frame/world/117_panel_keeper_top_x150.step
cad/v14/frame/world/117_panel_keeper_top_x50.step
cad/v14/frame/world/119_dummy_IEC_C14_inlet.step
cad/v14/frame/world/120_clip_C1_B_105.step
cad/v14/frame/world/120_clip_C1_B_111.step
cad/v14/frame/world/120_clip_C1_B_113.step
cad/v14/frame/world/120_clip_C1_B_115.step
cad/v14/frame/world/120_clip_C1_B_117.step
cad/v14/frame/world/120_clip_C1_B_119.step
cad/v14/frame/world/120_clip_C1_B_121.step
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
