jerrekt/Bricked-Sorting/(commit log)

2026-10-24 Demo site: landing with bin animation, simulated dashboard, bin table, CT 150 deploy files
    Claude-Session: https://claude.ai/code/session_0146zy9cxrsqeqrajxLhAutd
2026-10-24 Landing: team names, roles, instructor; hover link to bja.adsuaracloud.com
    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
2026-10-30 Add task chart handoff doc (how to build a team task board), from Ain't No Waymo
    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
2026-10-30 Task chart: add BOM sheet, slide deck upkeep, and the cardboard bin-size method (q27)
    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
2026-10-30 Task chart: add 7 real tasks (Canvas deadlines, camera design, CT 150 lockdown) and a Deadlines panel
    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
2026-10-31 Claim server, Discord commands and site buttons for the task chart; bots container setup
    - kratos/claim-bot: FastAPI + SQLite overlay (owner/status only, tasks.json stays the seed),
    Discord HTTP interactions with Ed25519 check, owner rules, channel feed via webhook,
    site routes behind the team password with lockout, opt-in flag, 25 tests (fake Discord).
    - web: Tasks page reads the live API when <meta name=bricked-api> is set, shows buttons
    and a name/password dialog; falls back to static tasks.json read-only (current state).
    - deploy/bots: shared bots container (per-bot user, root-only env file, hardened unit,
    firewall pattern from CT 312). No secrets.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
2026-11-01 Claim bot: PowerShell port of register_commands.py
    Same commands and API call; token read hidden and used once. Sends a DiscordBot user agent, since Discord answers 403 code 40333 to PowerShell's default.
2026-11-01 Site logo from Branden's artwork; Bricked Sorting icon set
    - Header on every page uses the new logo (gray background removed, 1x/2x).
    - Landing hero shows the logo large above the headline.
    - Icon: red brick on a blue brick (SVG + 32/180/192/512 PNG), web manifest, theme color.
    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
2026-11-02 Live page: camera pieces and simulator drop into bins; Marshall's bin bridge
    - kratos/claim-bot/live.py: Live service (off unless BRICKED_LIVE_ENABLED=1). Token-gated ingest from CT 150,
    JPEG thumbnails re-encoded in memory, public state and long-poll readers, simulator from the real 10696 list
    behind the team password (BRICKED_SIM_CONTROL=1), capped at 2 pieces/s and 10 min. 20 new tests (46 total).
    - kratos/live-hook: 15-line hook for CT 150's /identify, background thread, never blocks the Pi.
    - web/live.html + live.js: mode badge, last piece with photo, 16 bins with drop animation, recent list,
    Start/Stop/Reset behind the team password. Live link on every page.
    - indicate/: bin_brid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
    [bin-lookup.csv]
2026-11-03 Color groups: move five colors a basic RGB sensor would confuse
    Light Aqua and Lavender -> White / Light Gray, Bright Light Orange -> Yellow,
    Dark Purple -> Blue / Azure, Dark Brown -> Black / Dark Gray. Desk estimate from
    BrickLink colors, not a sensor test.
    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
2026-11-04 Parts page and buy list; /parts, /bought, /notbought in the claim bot
    - web/parts.html + assets/parts.js: buy list from data/build_parts.json, live
    bought flags from the claim bot (/api/parts), static fallback, Parts in the nav
    - web/data/build_parts.json: 34 parts (V3 ESP32 plan plus V1/V2 options),
    stage, qty, price, where, link
    - claim bot: /parts [show], /bought part, /notbought part; parts_merged passes
    extra top-level keys (stage_labels) through; README and env example
    - tests: Discord parts commands, gating, pass-through, seed file check (53 pass)
    - tasks.json: hw-05
    Claude-Session: https://claude.ai/code/session_0146zy9cx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
2026-11-04 Tasks: mark finished work done, add CAD tasks split by Isolate / Identify / Indicate
    - done: course-05, hw-01 (BOM Rev A), hw-05 (Parts page), indicate-06 (V10 bins settle the floor heights)
    - hw-02 in progress (V11 brick-shape CAD); details for indicate-01 and course-10
    - new milestones CAD: Isolate / Identify / Indicate (20 tasks: what is modeled in V11,
    what needs a test print, what is not drawn yet) plus 2 frame/electronics CAD tasks under Hardware
    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
2026-11-04 CAD tasks: all owned by Branden
    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
2026-11-04 Task board: 5 collapsible groups with progress bars, no buttons on done tasks
    - tasks.json groups: Isolate, Identify, Indicate (with bins), Build and parts, Site and class
    - each group is one button with done/total, a progress bar and in-progress/blocked/to-do counts;
    opening it shows its tasks under milestone subheads; open groups remembered per browser
    - done tasks show no Start/Blocked/Release buttons
    - old 'task chart is static' footer removed
    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
2026-11-04 Task board: size every task (S/M/L) and weight the group bars by work
    - tasks.json: size on all 74 tasks (24 S, 29 M, 21 L), done ones included; size_points S 1, M 2, L 4
    - group bar = done points / total points, with in-progress work as a lighter segment;
    header shows the weighted %, sub line shows tasks done and points
    - size badge on each task and a legend under the filters
    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
2026-11-04 Board: cardboard POC vs final version, checkpoint on every bar, progress card from tasks
    - tasks.json: phase on every task (54 poc, 32 final) and phases info (POC checkpoint 2026-12-02);
    cardboard tasks named and owned by the stage owners (Vivek, Ethan, Marshall); new tasks:
    cardboard scanner box, cardboard bins, cardboard POC run, and 9 final-version build and
    firmware tasks; CAD milestones renamed Final: Isolate / Identify / Indicate
    - every bar has a POC zone and a Final zone with a checkpoint marker between them
    - inside a group, tasks are split into Cardboard POC and Final version
    - Progress card is computed from the board (weighted), shows both phases, the days to the
    checkpoin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
2026-11-04 V1.015: site version in the header, changelog, intro animation
    - web/data/version.json + CHANGELOG.md (V1.001-V1.014 numbered from the 14 merged PRs)
    - tools/bump_version.py: one bump per merged PR; --check that every page shows it
    - version badge next to the logo on every page, links to the changelog; under the logo on phones
    - assets/intro.js: a blue 2x2 drops into the scanner, is identified, the chute swings to
    the blue bin and it drops in; once per session, tap/Esc skips, ?nointro, reduced motion
    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
2026-11-04 Intro: top view of our real sorter (wedge bin ring, scoop, trapdoors, lift)
    8 wedge bins on 22.5 deg slots in a half ring with the site colors, the tapered scoop turning
    about the yaw axis, two trapdoors under the camera, and a floor 1 / floor 2 lift gauge, as in
    the V10/V11 CAD.
    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
2026-11-04 V1.016: bigger logo on the intro on desktop
    Logo height clamp(40px, 9vw, 104px), was clamp(36px, 9vw, 56px): about 104 px tall on desktop,
    about 40 px on phones as before.
    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
2026-11-04 V1.017: task bars as Sem 1 / Sem 2 rows with the POC checkpoint flag
    Each bar is now two rows that both fill from the left: Sem 1 cardboard POC (red) ends at a
    flag 'POC Dec 2' that turns green when every POC task is done, and Sem 2 final (green).
    Same rows on the Progress card. The old single bar with the pin let final work float ahead
    of an empty POC zone, and Site and class had no flag at all.
    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
2026-11-04 Buy list: three condensed layouts with prices to choose from (?opt=a|b|c), not the default yet
    - build_parts.json: cost (USD), approx and type on every part, type_labels
    - parts.js: ?opt=a stage groups, ?opt=b by store, ?opt=c cost overview by type; collapsible
    groups with on-hand value bars and $ to buy; totals for the planned V3 build, test set excluded
    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
2026-11-04 V1.018: buy list grouped by stage with prices (option A)
    - collapsible stage groups like the task board: $ to buy, on-hand value bar, parts on hand
    - one-line rows: status dot, part, qty, store link, price, Mark bought; notes only on parts to buy
    - totals for the planned V3 build (switchable), LEGO test set listed but not counted
    - removed the old flat list and the B/C previews
    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
2026-11-04 V1.020: V12 CAD closes eight CAD tasks; 2020 extrusion and T-nuts on the buy list
    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
2026-11-06 CAD: V14 shared interface for parallel chats and the V13 reference pack
    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
    [01_ground_base.step, 02_moving_carriage_v3.step, 03_top_rod_brace.step, 04_lower_switch_mount.step, 05_open_scoop_PRINT_FLAT.step, 06_angled_shaft_hub.step, 07_upper_switch_rod_mount.step, 08_rod_fit_test.step]
2026-11-06 V14 interface: slide uses the salvaged NEMA17, no lead-screw motor
    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
2026-11-06 Review brief: add the old Z + yaw scoop question
    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
2026-11-06 Review brief: note the V13 Z + yaw design is fully modeled and animated
    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
2026-11-06 V14 interface 3: box beam, scoop margin, roller runners, two drawer switches, keyed drawers
    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
2026-11-06 V14 interface 4: under-drawer rails through the spine, lower funnel, scoop geometry, 5-segment beam, drag chain
    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
2026-11-06 Interface 4: bins ~145 tall over the under-drawer rails
    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
2026-11-06 Interface 4.1: 26 mm spine tunnels, bins ~139; frozen
    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
2026-11-06 Interface 4.2: print-friendly rules, 2.4 mm wall skin, shorter access panel
    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
2026-11-06 Interface 4.3: print rules from BJ's measured settings in the vault runbook
    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
2026-11-06 V14 interface 5: 720 x 360 x 664 body, wood frame (2x2/1x2, 1/2 in ply), 2 mm red PLA skin, 0.58 L bins
    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
2026-11-06 V14 module F (frame + skin) to interface 5: wood cut list, drilling map, 2 mm skin tiles on channel clips, access panel, roof, studs, corner caps
    Claude-Session: https://claude.ai/code/session_01RWaNJC8nwuoqbMJ8zSSGLi
    [100_post_2x2_LB.step, 100_post_2x2_LF.step, 100_post_2x2_RB.step, 100_post_2x2_RF.step, 101_top_rail_long_B.step, 101_top_rail_long_F.step, 102_top_rail_short_L.step, 102_top_rail_short_R.step]
2026-11-07 Interface 5.1: drawer fits the skin opening (76 pitch, body +-306, overlay faces), roof support under the hopper
    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
2026-11-07 Frame to interface 5.1: openings x +-310 z 12..136, two flat 1x2 roof cross rails under the hopper stud, C3 clips moved clear of them
    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
    [100_post_2x2_LB.step, 100_post_2x2_LF.step, 100_post_2x2_RB.step, 100_post_2x2_RF.step, 101_top_rail_long_B.step, 101_top_rail_long_F.step, 102_top_rail_short_L.step, 102_top_rail_short_R.step]
2026-11-07 Frame: drawer check against the 5.1 drawers (cad-v14-all @86274c8)
    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
2026-11-08 Frame: front/back skin back at y +-180 (5.1 envelope y +-192 includes the drawer faces, not the skin)
    build_frame.py read IF['envelope']['y'] as the skin plane; after 5.1 changed the envelope to +-192 for the
    overlay drawer faces, the front/back tiles, corner caps, panel and keepers moved out 12 mm and clashed with
    the faces. YO is now the skin's outer face (180) per interface skin.outer_faces.
    Claude-Session: https://claude.ai/code/session_01RWaNJCKX7MuXuoPSJJxker
    [100_post_2x2_LB.step, 100_post_2x2_LF.step, 100_post_2x2_RB.step, 100_post_2x2_RF.step, 101_top_rail_long_B.step, 101_top_rail_long_F.step, 102_top_rail_short_L.step, 102_top_rail_short_R.step]
2026-11-08 Frame: drawer check re-run against the fixed skin (all clean); correct the 11-06 note
    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
2026-11-08 Frame: posts to floor ply with #6 x 1-1/4 (4 per post), drop the #8 x 2 pack
    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
    [100_post_2x2_LB.step, 100_post_2x2_LF.step, 100_post_2x2_RB.step, 100_post_2x2_RF.step, 101_top_rail_long_B.step, 101_top_rail_long_F.step, 102_top_rail_short_L.step, 102_top_rail_short_R.step]
2026-11-08 Frame: IEC C14 fused/switched inlet cutout in back tile B c1 r3 above the PSU (Nov 8 electrical update)
    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
    [100_post_2x2_LB.step, 100_post_2x2_LF.step, 100_post_2x2_RB.step, 100_post_2x2_RF.step, 101_top_rail_long_B.step, 101_top_rail_long_F.step, 102_top_rail_short_L.step, 102_top_rail_short_R.step]
2026-11-09 M3 insert hole 4.3 in PLA (tested by BJ 2026-11-09: 4.4 loose, 4.3 press fit); rebuilt
    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
    [100_post_2x2_LB.step, 100_post_2x2_LF.step, 100_post_2x2_RB.step, 100_post_2x2_RF.step, 101_top_rail_long_B.step, 101_top_rail_long_F.step, 102_top_rail_short_L.step, 102_top_rail_short_R.step]
2026-11-10 Frame: stud cap 131 screw ring gets a 45 deg chamfer so P9 prints without supports
    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
    [100_post_2x2_LB.step, 100_post_2x2_LF.step, 100_post_2x2_RB.step, 100_post_2x2_RF.step, 101_top_rail_long_B.step, 101_top_rail_long_F.step, 102_top_rail_short_L.step, 102_top_rail_short_R.step]
2026-11-13 Print STLs re-posed for no supports (auto_orient: 6 face-down poses, keeps the designer's pose when it already needs none); build scripts run it after export
    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
